zesamoht/Keep-Talking-Project/README.md

# Keep-Talking-Project

A physical homage to the game Keep Talking and Nobody Explode

<p align="center">
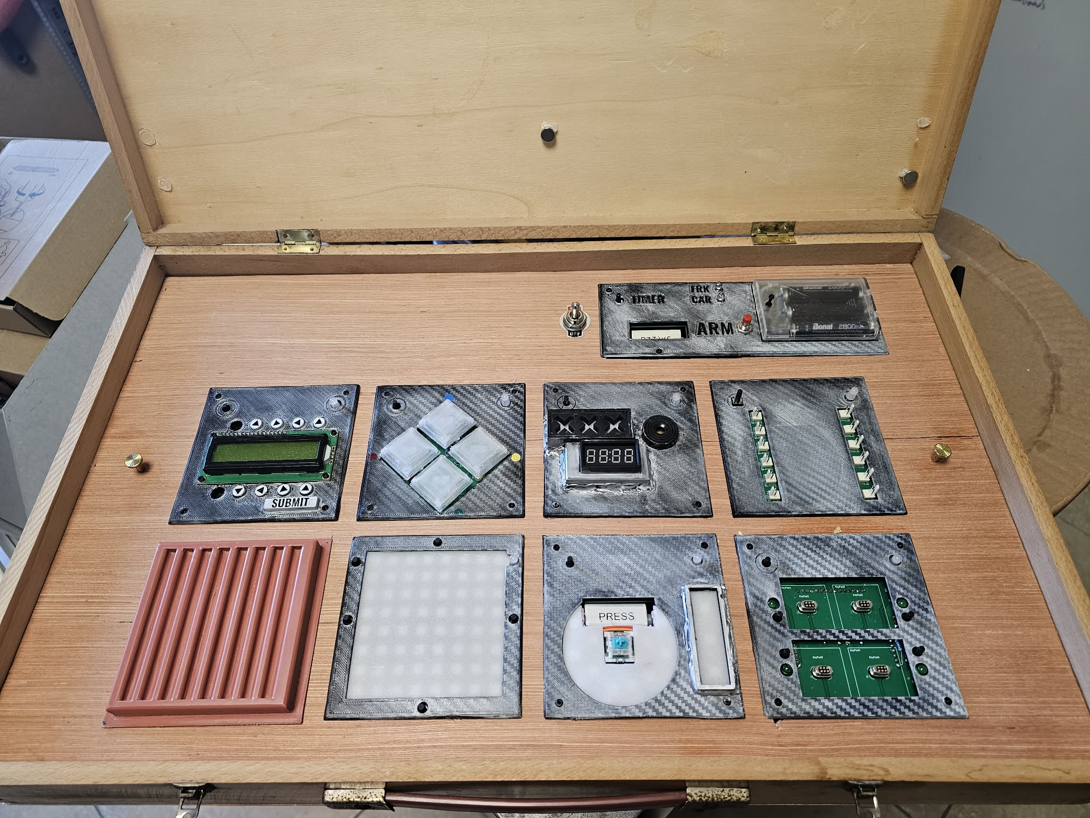
[picture p1: docs/KT_Project.jpg]
  
</p>
