zesamoht/Keep-Talking-Project/arduino/README.md

this folder contains all the arduino code for the working modules
