zesamoht/Keep-Talking-Project/kicad/README.md

For Kicad drawings to be used in the physical manufacturing of the PCB
