zesamoht/Keep-Talking-Project/kicad/Button_Module/EdgeWork_Module.step

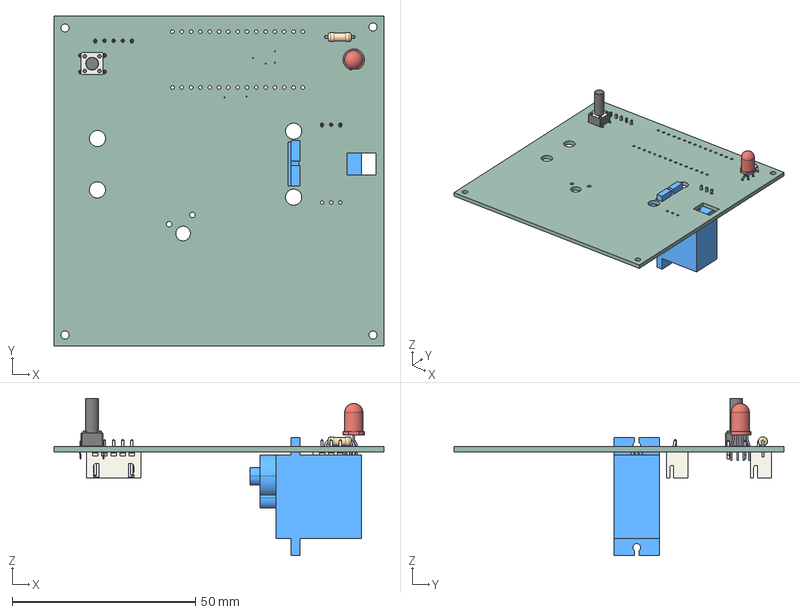
[picture p2: CAD file, 2026-04-25]
kicad/Button_Module/EdgeWork_Module.step
90.0 x 90.0 x 42.9 mm
R_Axial_DIN0207_L6.3mm_D2.5mm_P7.62mm_Horizontal
SW_PUSH_6mm_H13mm
LED_D5.0mm-4_RGB_Staggered_Pins
JST_XH_B5B-XH-A_1x05_P2.50mm_Vertical
JST_XH_B3B-XH-A_1x03_P2.50mm_Vertical
SG90 servo
Button_Module_PCB
