zesamoht/Keep-Talking-Project/kicad/Countdown_Module/Countdown_Module.step

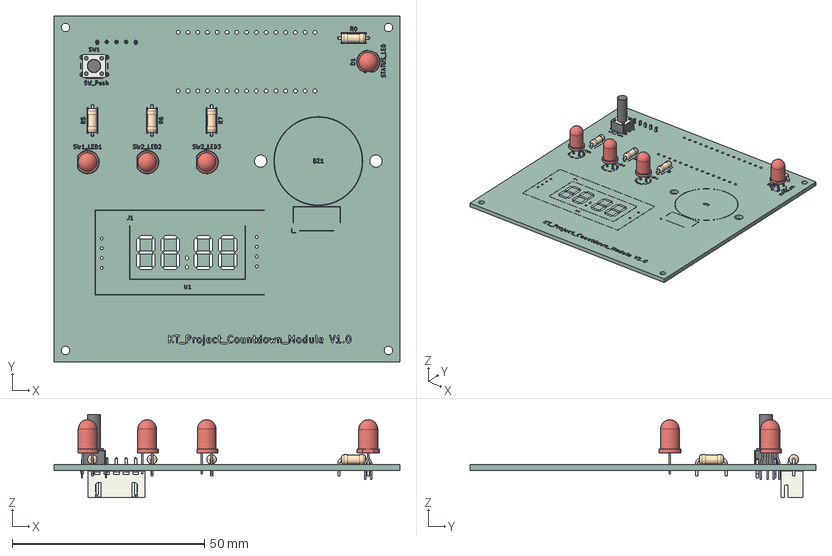
[picture p3: CAD file, 2026-04-25]
kicad/Countdown_Module/Countdown_Module.step
90.0 x 90.0 x 21.7 mm
LED_D5.0mm-4_RGB_Staggered_Pins
R_Axial_DIN0207_L6.3mm_D2.5mm_P7.62mm_Horizontal x 4
LED_D5.0mm x 3
SW_PUSH_6mm_H13mm
JST_XH_B5B-XH-A_1x05_P2.50mm_Vertical
Countdown_Module_silkscreen
Countdown_Module_PCB
