zesamoht/Keep-Talking-Project/kicad/Keypad_PCB/Keypad_PCB.step

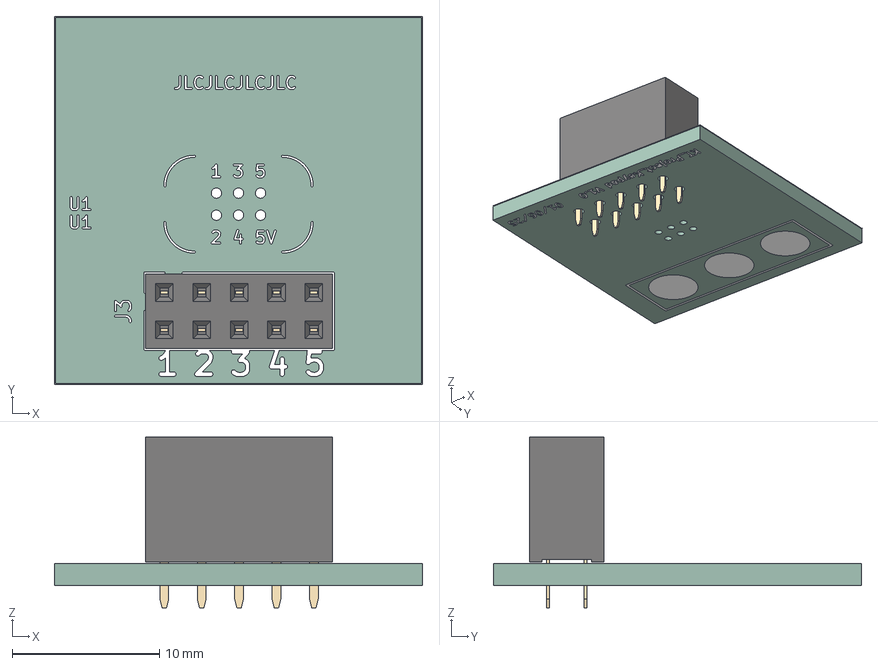
[picture p4: CAD file, 2026-04-25]
kicad/Keypad_PCB/Keypad_PCB.step
25.0 x 25.0 x 11.6 mm
PinSocket_2x05_P2.54mm_Vertical
Keypad_PCB_silkscreen
Keypad_PCB_PCB
