zesamoht/Keep-Talking-Project/kicad/Maze_Module/Maze_Module.step

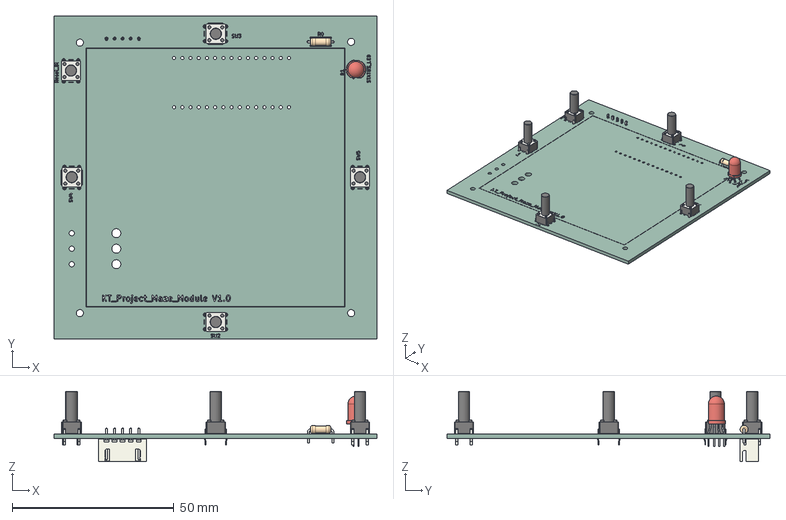
[picture p5: CAD file, 2026-04-25]
kicad/Maze_Module/Maze_Module.step
100.0 x 100.0 x 21.7 mm
R_Axial_DIN0207_L6.3mm_D2.5mm_P7.62mm_Horizontal
SW_PUSH_6mm_H13mm x 5
LED_D5.0mm-4_RGB_Staggered_Pins
JST_XH_B5B-XH-A_1x05_P2.50mm_Vertical
Maze_Module_silkscreen
Maze_Module_PCB
