zesamoht/Keep-Talking-Project/kicad/Password_Module/Password_Module.step

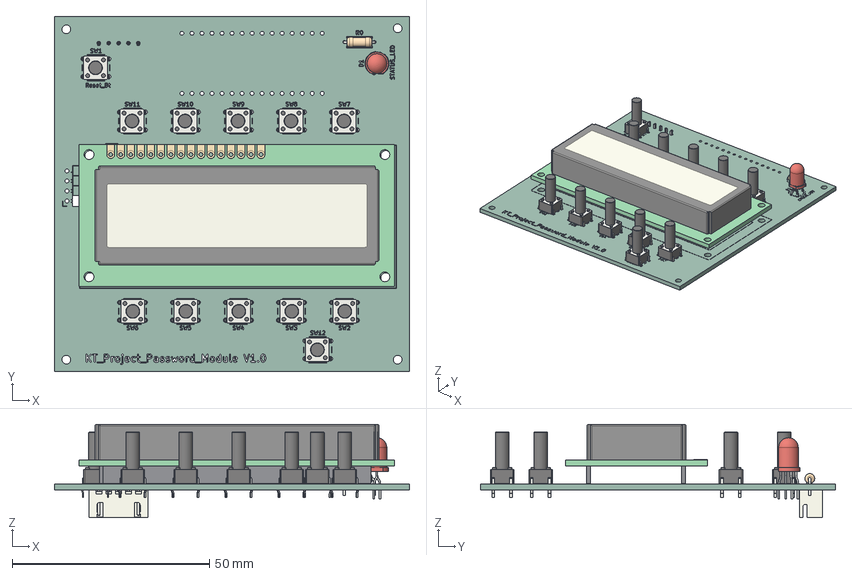
[picture p6: CAD file, 2026-04-25]
kicad/Password_Module/Password_Module.step
90.0 x 90.0 x 23.7 mm
R_Axial_DIN0207_L6.3mm_D2.5mm_P7.62mm_Horizontal
SW_PUSH_6mm_H13mm x 12
WC1602A
LED_D5.0mm-4_RGB_Staggered_Pins
JST_XH_B5B-XH-A_1x05_P2.50mm_Vertical
Password_Module_silkscreen
Password_Module_PCB
