zesamoht/Keep-Talking-Project/kicad/SimonSay_Module/SimonSay_Module.step

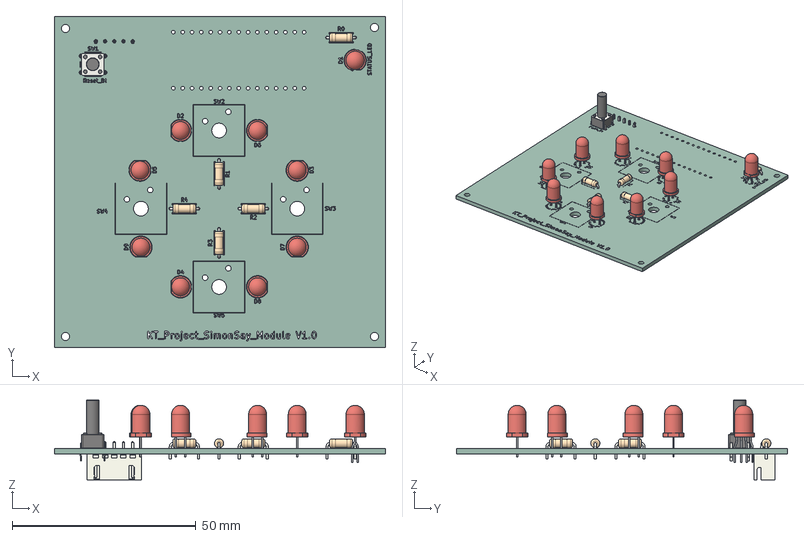
[picture p7: CAD file, 2026-04-25]
kicad/SimonSay_Module/SimonSay_Module.step
90.0 x 90.0 x 21.7 mm
LED_D5.0mm x 8
R_Axial_DIN0207_L6.3mm_D2.5mm_P7.62mm_Horizontal x 5
SW_PUSH_6mm_H13mm
LED_D5.0mm-4_RGB_Staggered_Pins
JST_XH_B5B-XH-A_1x05_P2.50mm_Vertical
SimonSay_Module_silkscreen
SimonSay_Module_PCB
