zesamoht/Keep-Talking-Project/kicad/Wire_Module/Wire_Module.step

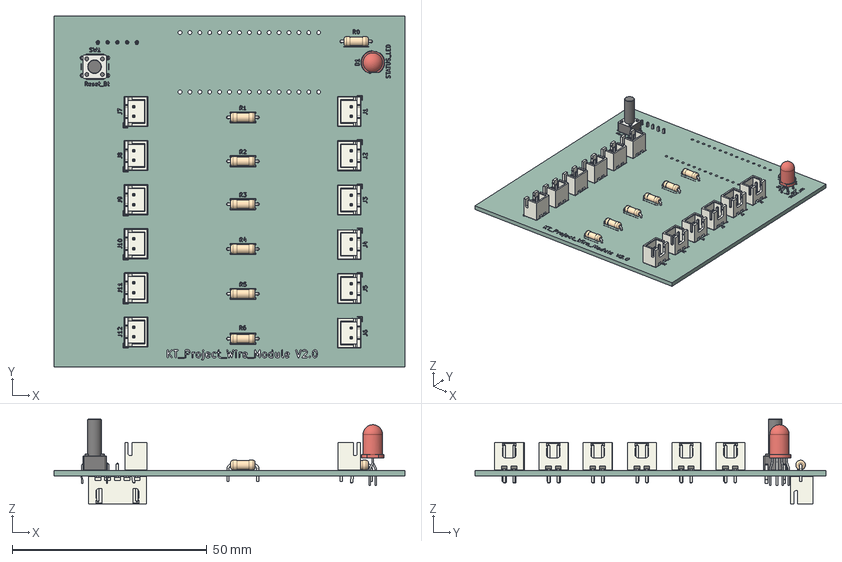
[picture p8: CAD file, 2026-04-25]
kicad/Wire_Module/Wire_Module.step
90.0 x 90.0 x 21.7 mm
R_Axial_DIN0207_L6.3mm_D2.5mm_P7.62mm_Horizontal x 7
JST_XH_B2B-XH-A_1x02_P2.50mm_Vertical x 12
SW_PUSH_6mm_H13mm
LED_D5.0mm-4_RGB_Staggered_Pins
JST_XH_B5B-XH-A_1x05_P2.50mm_Vertical
Wire_Module_silkscreen
Wire_Module_PCB
