zesamoht/Keep-Talking-Project/kicad/Password_Module/Password_Module.kicad_pcb

## KiCad design kicad/Password_Module/Password_Module.kicad_pcb (2026-04-25)

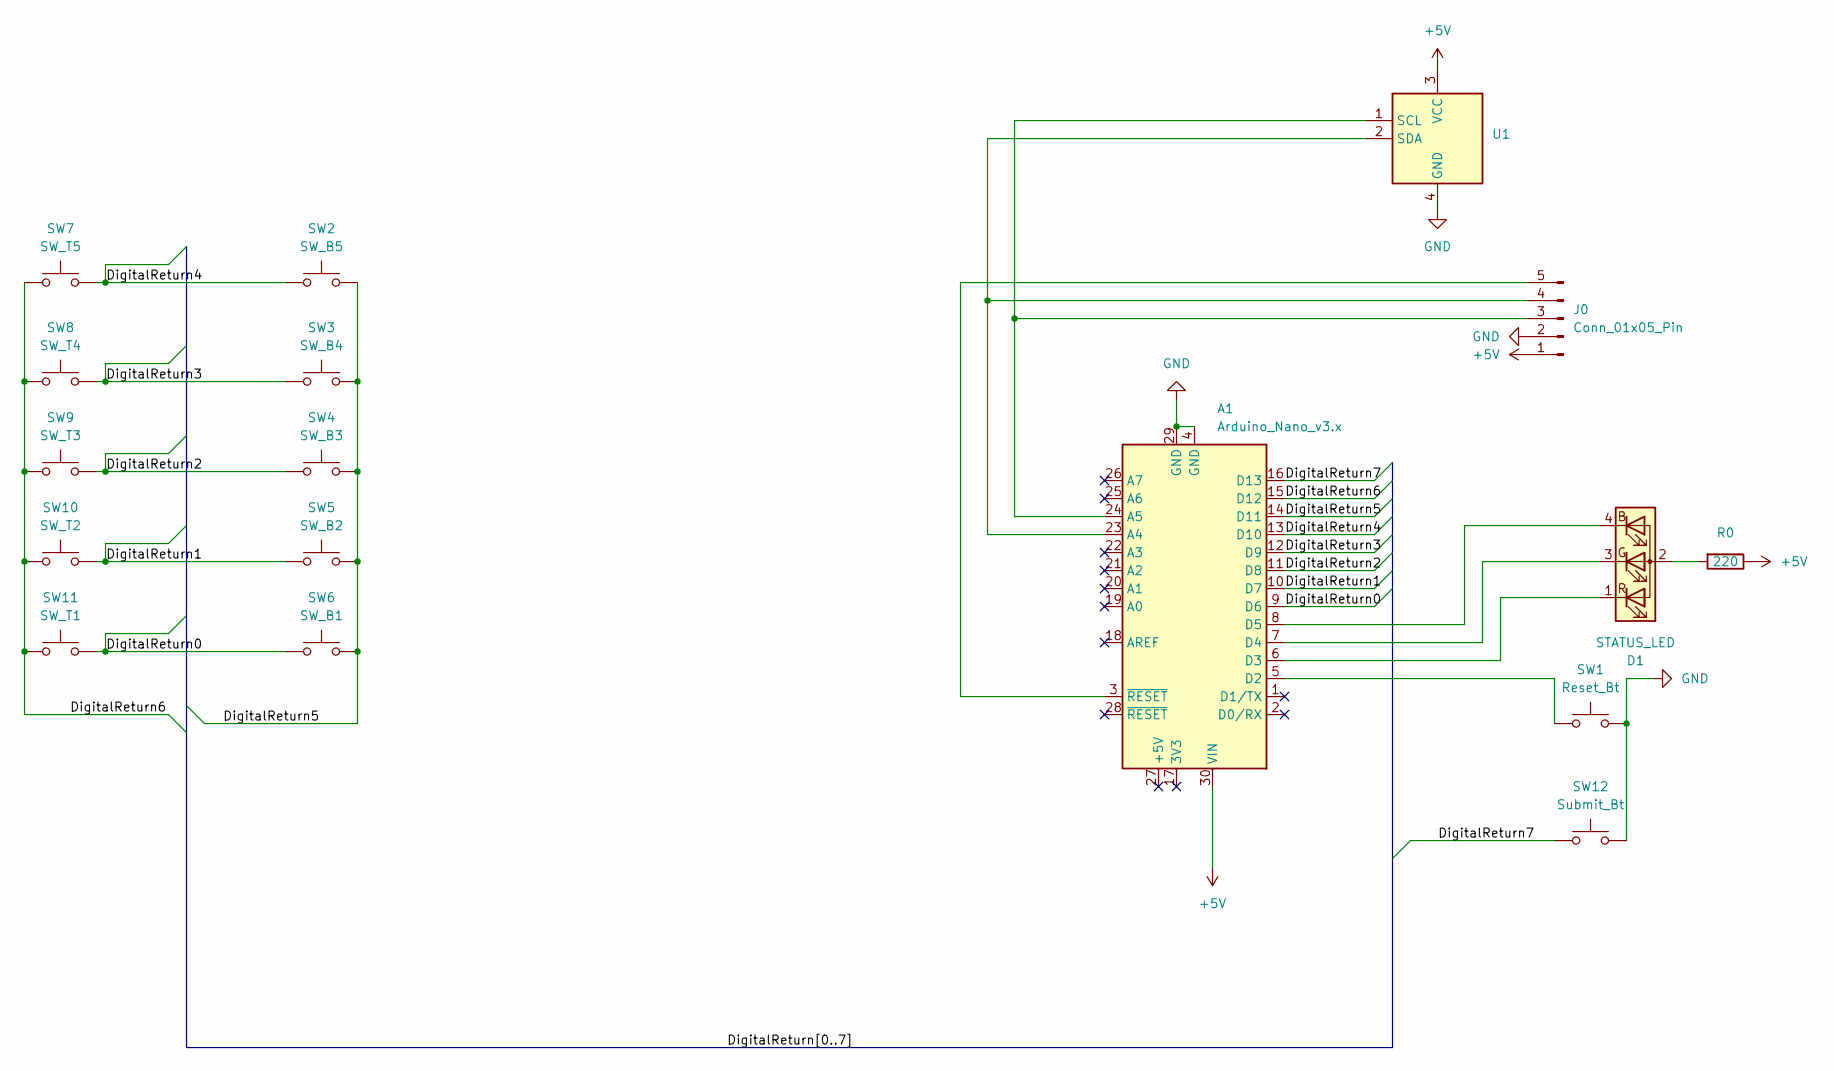
[picture p9: schematic Password_Module.kicad_sch]

Parts:
A1: Arduino_Nano_v3.x; Arduino_Nano
D1: STATUS_LED; LED_D5.0mm-4_RGB_Staggered_Pins
J0: Conn_01x05_Pin; JST_XH_B5B-XH-A_1x05_P2.50mm_Vertical
R0: 220; R_Axial_DIN0207_L6.3mm_D2.5mm_P7.62mm_Horizontal
SW1: Reset_Bt; SW_PUSH_6mm_H13mm
SW2: SW_B5; SW_PUSH_6mm_H13mm
SW3: SW_B4; SW_PUSH_6mm_H13mm
SW4: SW_B3; SW_PUSH_6mm_H13mm
SW5: SW_B2; SW_PUSH_6mm_H13mm
SW6: SW_B1; SW_PUSH_6mm_H13mm
SW7: SW_T5; SW_PUSH_6mm_H13mm
SW8: SW_T4; SW_PUSH_6mm_H13mm
SW9: SW_T3; SW_PUSH_6mm_H13mm
SW10: SW_T2; SW_PUSH_6mm_H13mm
SW11: SW_T1; SW_PUSH_6mm_H13mm
SW12: Submit_Bt; SW_PUSH_6mm_H13mm
U1: LCD I2C 8x2 (PCF8574T) I2C

Connections:
+5V: A1.30 (VIN), J0.1, R0.1, U1.3 (VCC)
/DigitalReturn0: A1.9 (D6), SW6.2, SW11.2
/DigitalReturn1: A1.10 (D7), SW5.2, SW10.2
/DigitalReturn2: A1.11 (D8), SW4.2, SW9.2
/DigitalReturn3: A1.12 (D9), SW3.2, SW8.2
/DigitalReturn4: A1.13 (D10), SW2.2, SW7.2
/DigitalReturn5: A1.14 (D11), SW2.1, SW3.1, SW4.1, SW5.1, SW6.1
/DigitalReturn6: A1.15 (D12), SW7.1, SW8.1, SW9.1, SW10.1, SW11.1
/DigitalReturn7: A1.16 (D13), SW12.1
GND: A1.4 (GND), A1.29 (GND), J0.2, SW1.2, SW12.2, U1.4 (GND)
unnamed: A1.23 (A4), J0.4, U1.2 (SDA)
unnamed: A1.24 (A5), J0.3, U1.1 (SCL)
unnamed: A1.5 (D2), SW1.1
unnamed: A1.6 (D3), D1.1 (RK)
unnamed: A1.7 (D4), D1.3 (GK)
unnamed: A1.8 (D5), D1.4 (BK)
unnamed: D1.2 (A), R0.2
unnamed: A1.3 (~RESET), J0.5

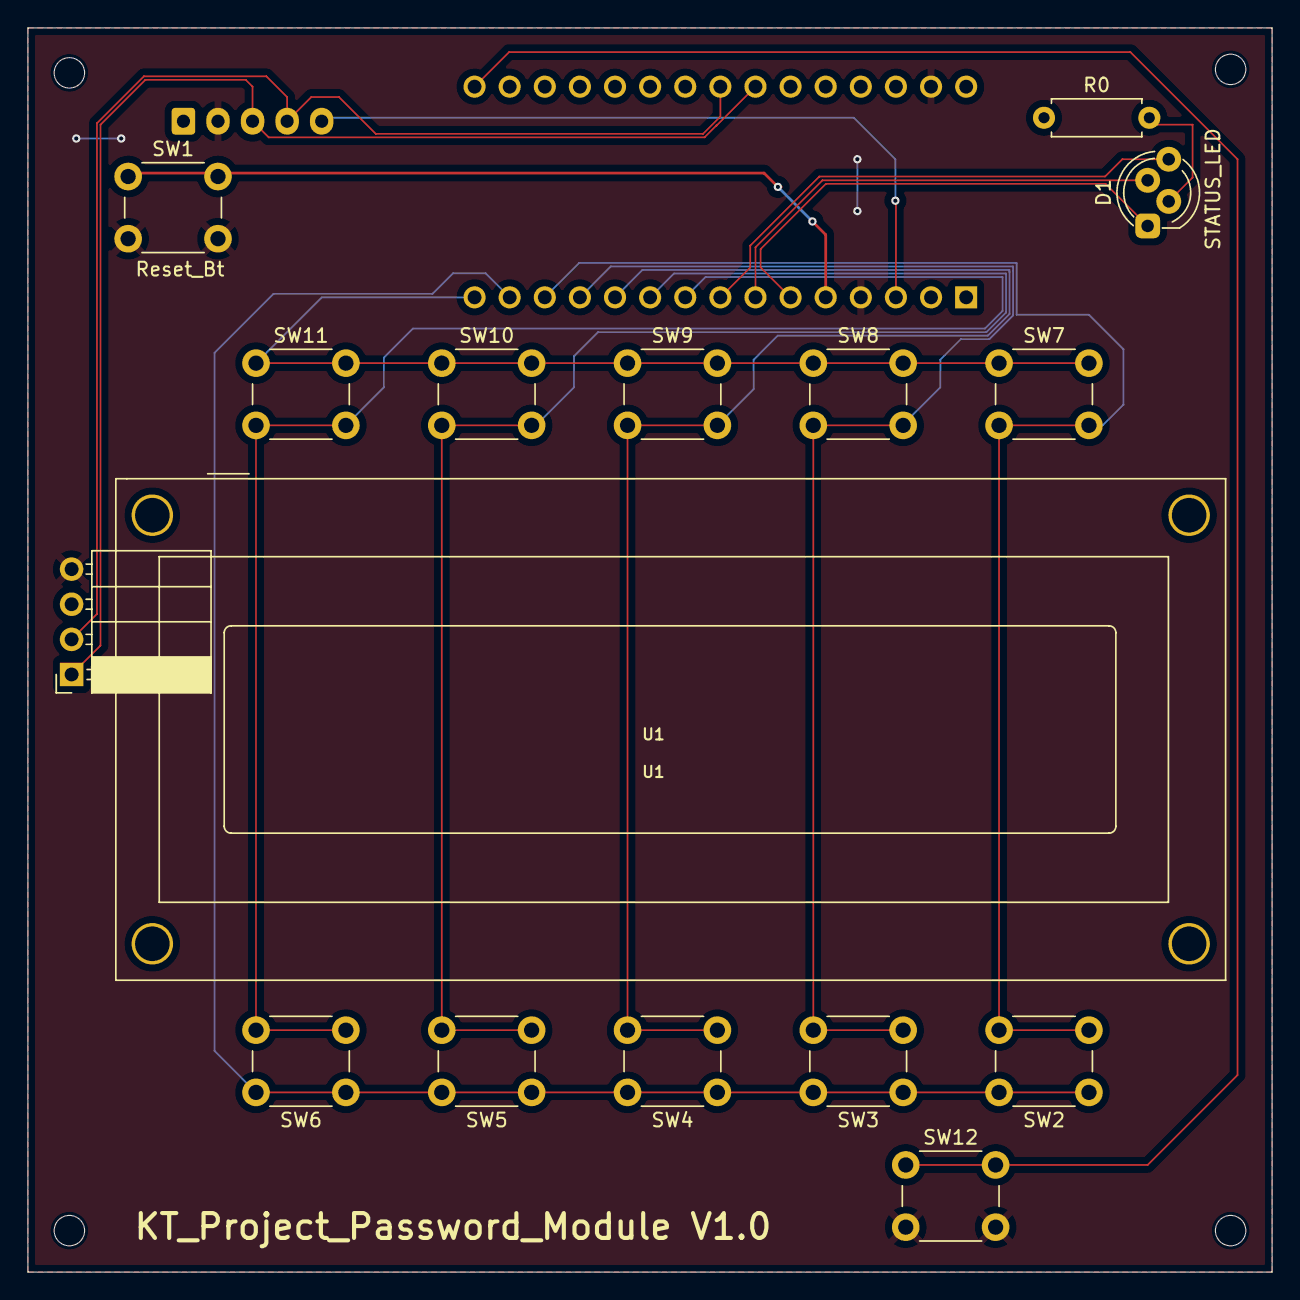
[picture p10: board Password_Module.kicad_pcb from above]

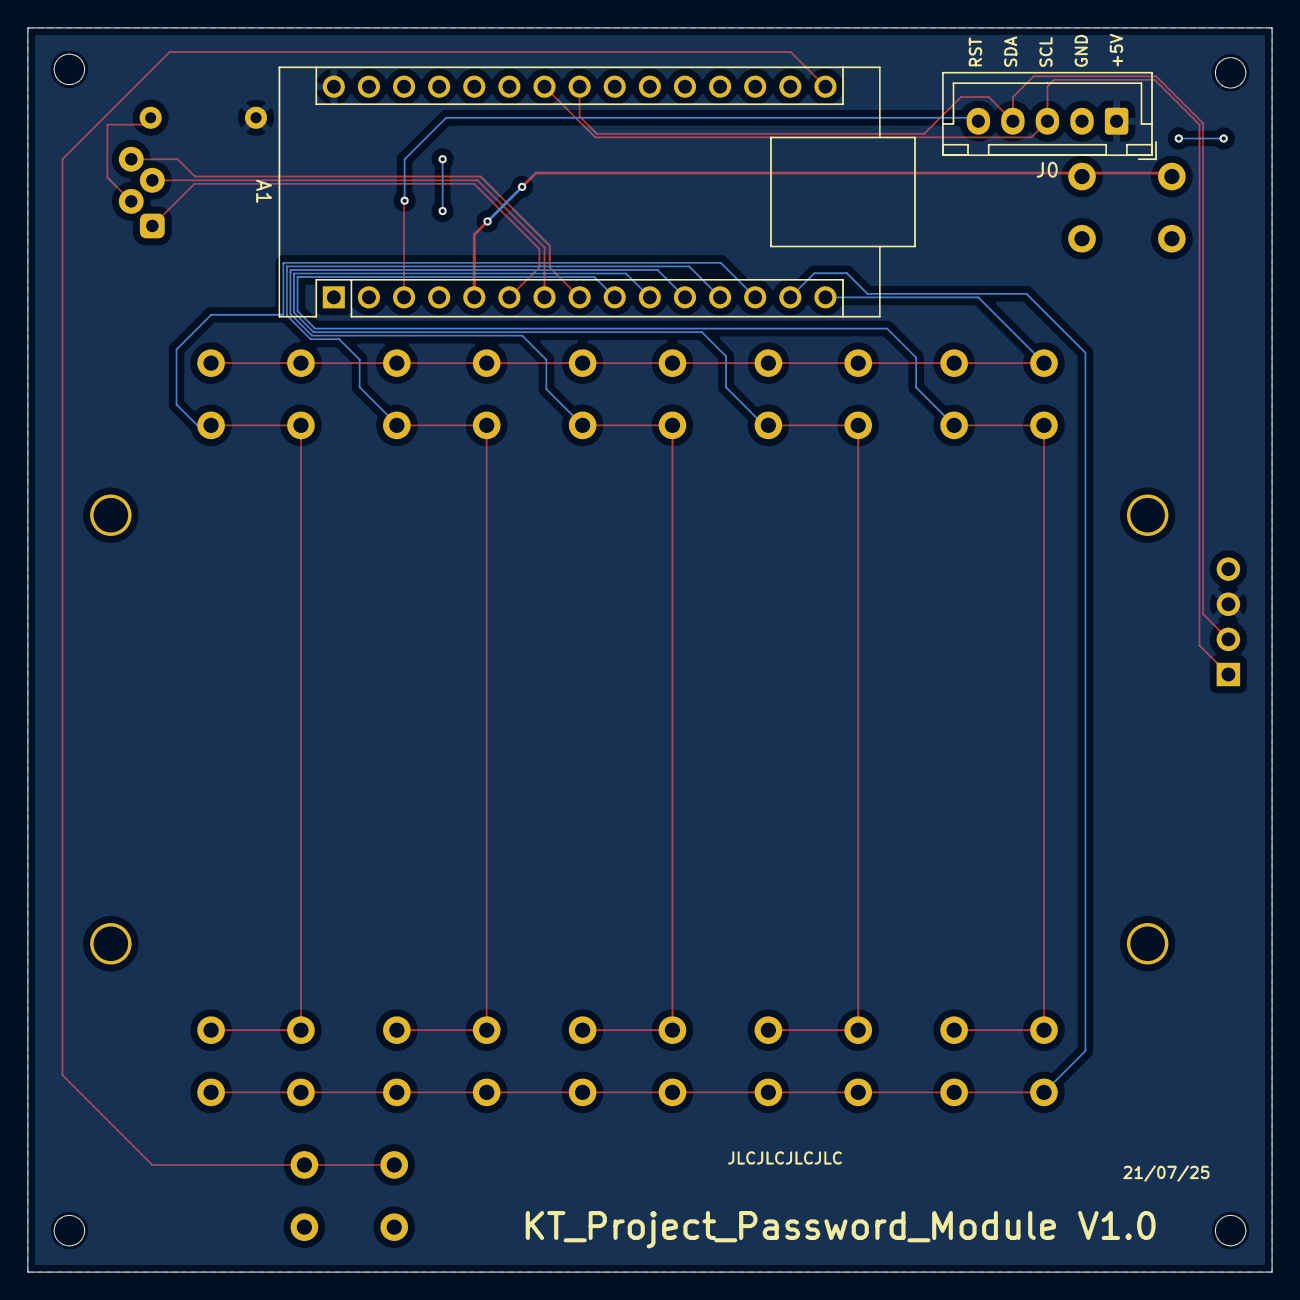
[picture p11: board Password_Module.kicad_pcb from below]

Board: 2 copper layers, 90.0 x 90.0 mm, 17 parts (2 on the bottom side), 18 nets.
