zesamoht/Keep-Talking-Project/kicad/Memory_Module/Memory_Module.kicad_pcb

## KiCad design kicad/Memory_Module/Memory_Module.kicad_pcb (2026-04-25)

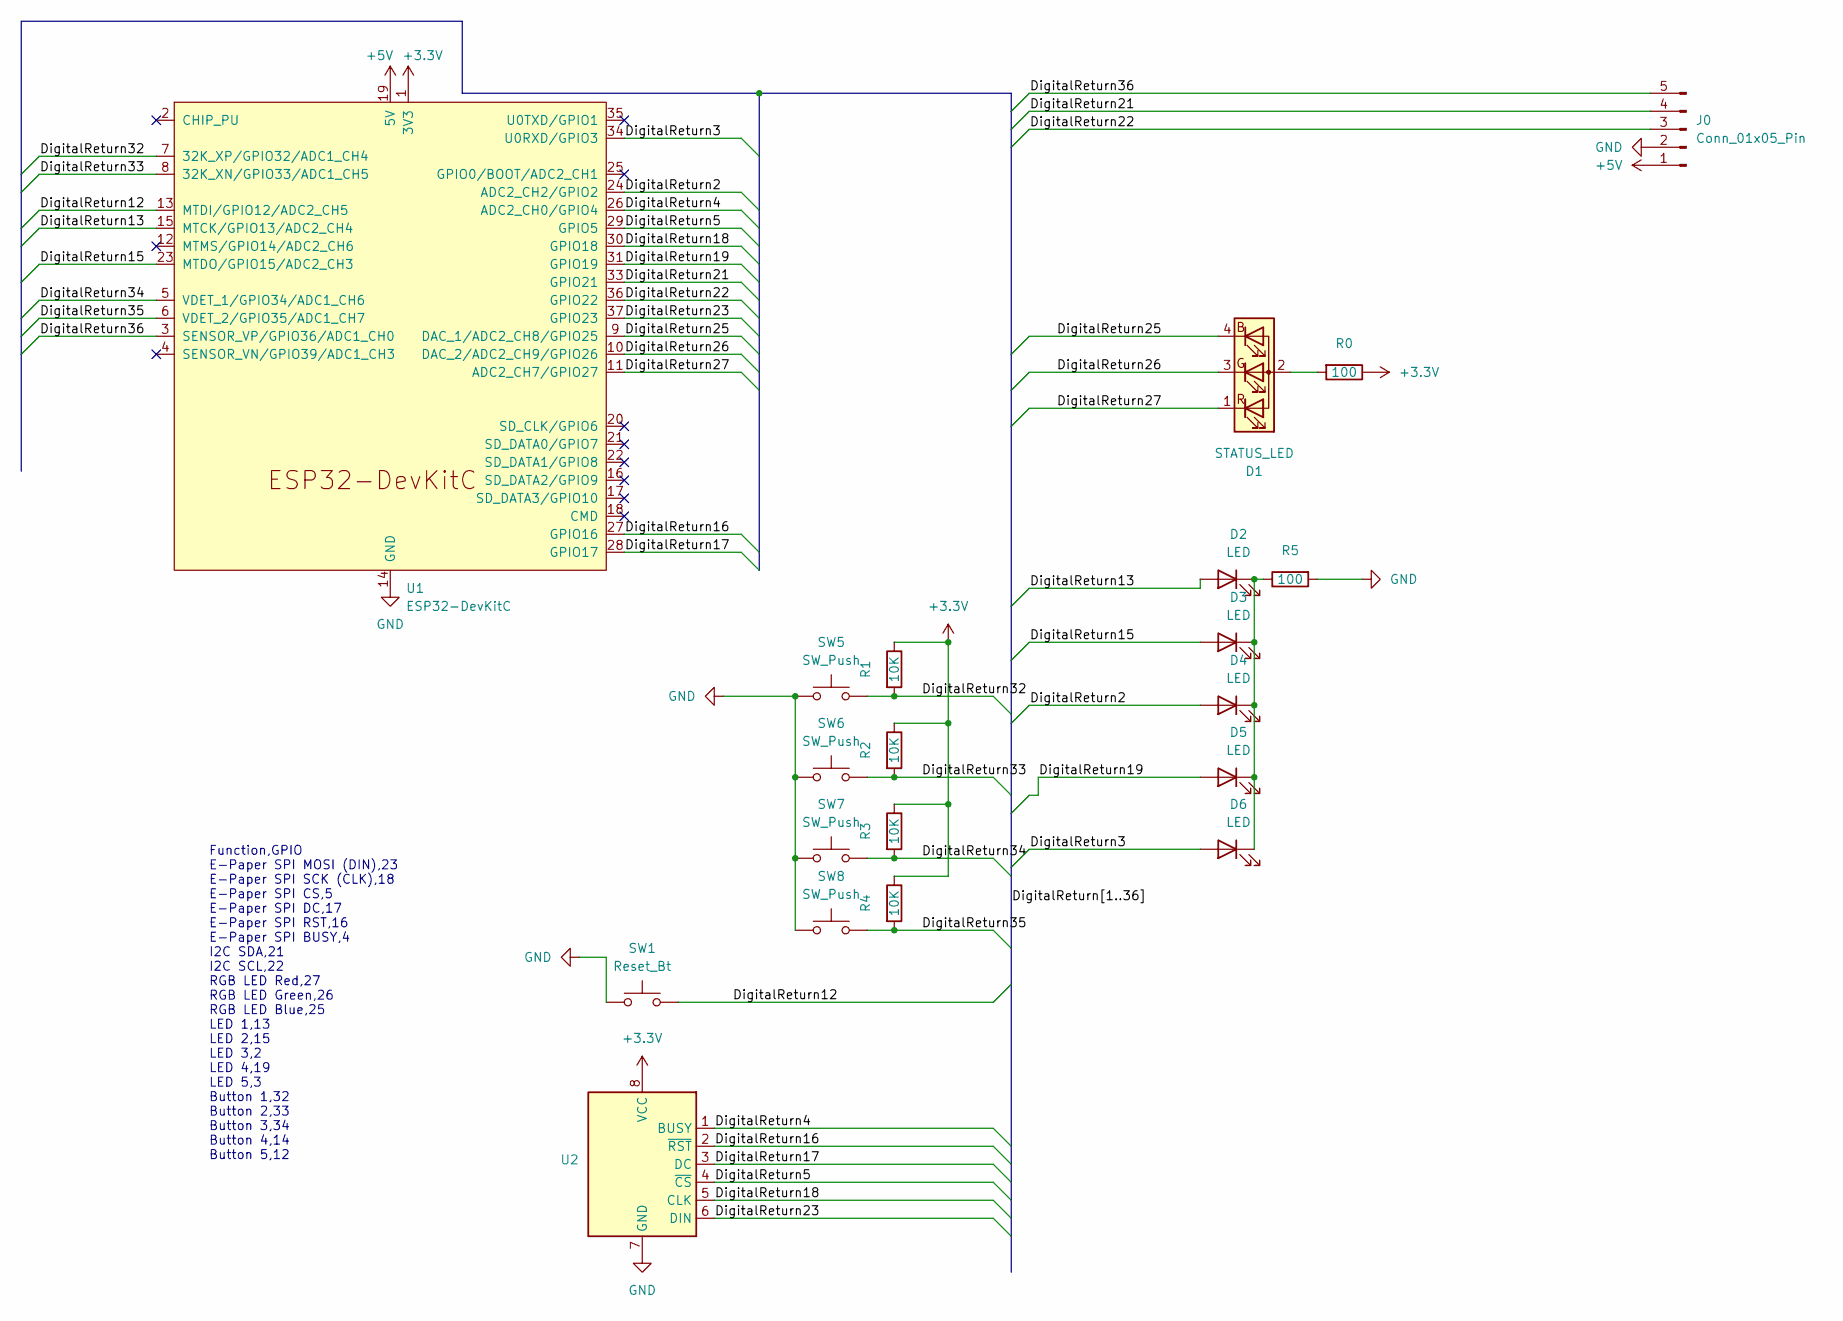
[picture p12: schematic Memory_Module.kicad_sch]

Parts:
D1: STATUS_LED; LED_D5.0mm-4_RGB_Staggered_Pins
D2, D3, D4, D5, D6: LED; LED_D5.0mm
J0: Conn_01x05_Pin; JST_XH_B5B-XH-A_1x05_P2.50mm_Vertical
R0, R5: 100; R_Axial_DIN0207_L6.3mm_D2.5mm_P7.62mm_Horizontal
R1, R2, R3, R4: 10K; R_Axial_DIN0207_L6.3mm_D2.5mm_P7.62mm_Horizontal
SW1: Reset_Bt; SW_PUSH_6mm_H13mm
SW5, SW6, SW7, SW8: SW_Push; SW_PUSH_6mm_H13mm
U1: ESP32-DevKitC
U2: WaveShare_E-Paper_Display_200x200

Connections:
+3.3V: R0.1, R1.1, R2.1, R3.1, R4.1, U1.1 (3V3), U2.8 (VCC)
+5V: J0.1, U1.19 (5V)
/DigitalReturn2: D4.2 (A), U1.24 (ADC2_CH2/GPIO2)
/DigitalReturn3: D6.2 (A), U1.34 (U0RXD/GPIO3)
/DigitalReturn4: U1.26 (ADC2_CH0/GPIO4), U2.1 (BUSY)
/DigitalReturn5: U1.29 (GPIO5), U2.4 (~CS)
/DigitalReturn12: SW1.1, U1.13 (MTDI/GPIO12/ADC2_CH5)
/DigitalReturn13: D2.2 (A), U1.15 (MTCK/GPIO13/ADC2_CH4)
/DigitalReturn15: D3.2 (A), U1.23 (MTDO/GPIO15/ADC2_CH3)
/DigitalReturn16: U1.27 (GPIO16), U2.2 (~RST)
/DigitalReturn17: U1.28 (GPIO17), U2.3 (DC)
/DigitalReturn18: U1.30 (GPIO18), U2.5 (CLK)
/DigitalReturn19: D5.2 (A), U1.31 (GPIO19)
/DigitalReturn21: J0.4, U1.33 (GPIO21)
/DigitalReturn22: J0.3, U1.36 (GPIO22)
/DigitalReturn23: U1.37 (GPIO23), U2.6 (DIN)
/DigitalReturn25: D1.4 (BK), U1.9 (DAC_1/ADC2_CH8/GPIO25)
/DigitalReturn26: D1.3 (GK), U1.10 (DAC_2/ADC2_CH9/GPIO26)
/DigitalReturn27: D1.1 (RK), U1.11 (ADC2_CH7/GPIO27)
/DigitalReturn32: R1.2, SW5.2, U1.7 (32K_XP/GPIO32/ADC1_CH4)
/DigitalReturn33: R2.2, SW6.2, U1.8 (32K_XN/GPIO33/ADC1_CH5)
/DigitalReturn34: R3.2, SW7.2, U1.5 (VDET_1/GPIO34/ADC1_CH6)
/DigitalReturn35: R4.2, SW8.2, U1.6 (VDET_2/GPIO35/ADC1_CH7)
/DigitalReturn36: J0.5, U1.3 (SENSOR_VP/GPIO36/ADC1_CH0)
GND: J0.2, R5.2, SW1.2, SW5.1, SW6.1, SW7.1, SW8.1, U1.14 (GND), U1.32 (GND), U1.38 (GND), U2.7 (GND)
unnamed: D1.2 (A), R0.2
unnamed: D2.1 (K), D3.1 (K), D4.1 (K), D5.1 (K), D6.1 (K), R5.1

Notes on the sheet:
Function,GPIO E-Paper SPI MOSI (DIN),23 E-Paper SPI SCK (CLK),18 E-Paper SPI CS,5 E-Paper SPI DC,17 E-Paper SPI RST,16 E-Paper SPI BUSY,4 I2C SDA,21 I2C SCL,22 RGB LED Red,27 RGB LED Green,26 RGB LED Blue,25 LED 1,13 LED 2,15 LED 3,2 LED 4,19 LED 5,3 Button 1,32 Button 2,33 Button 3,34 Button 4,14 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

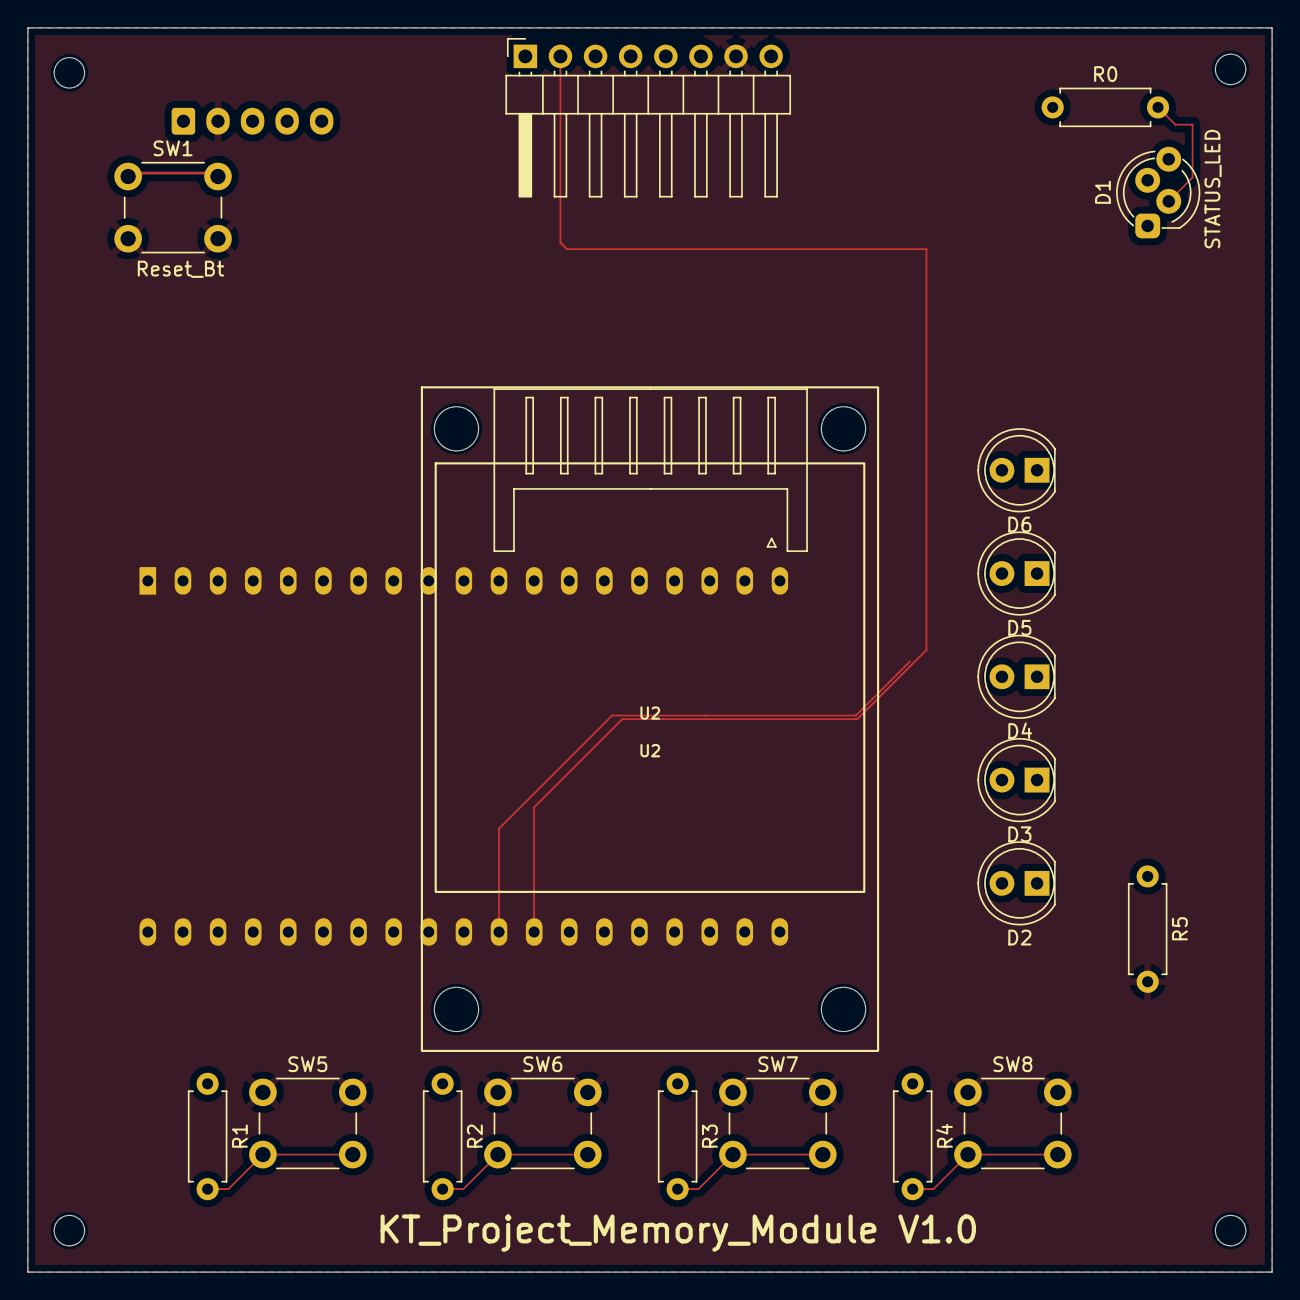
[picture p13: board Memory_Module.kicad_pcb from above]

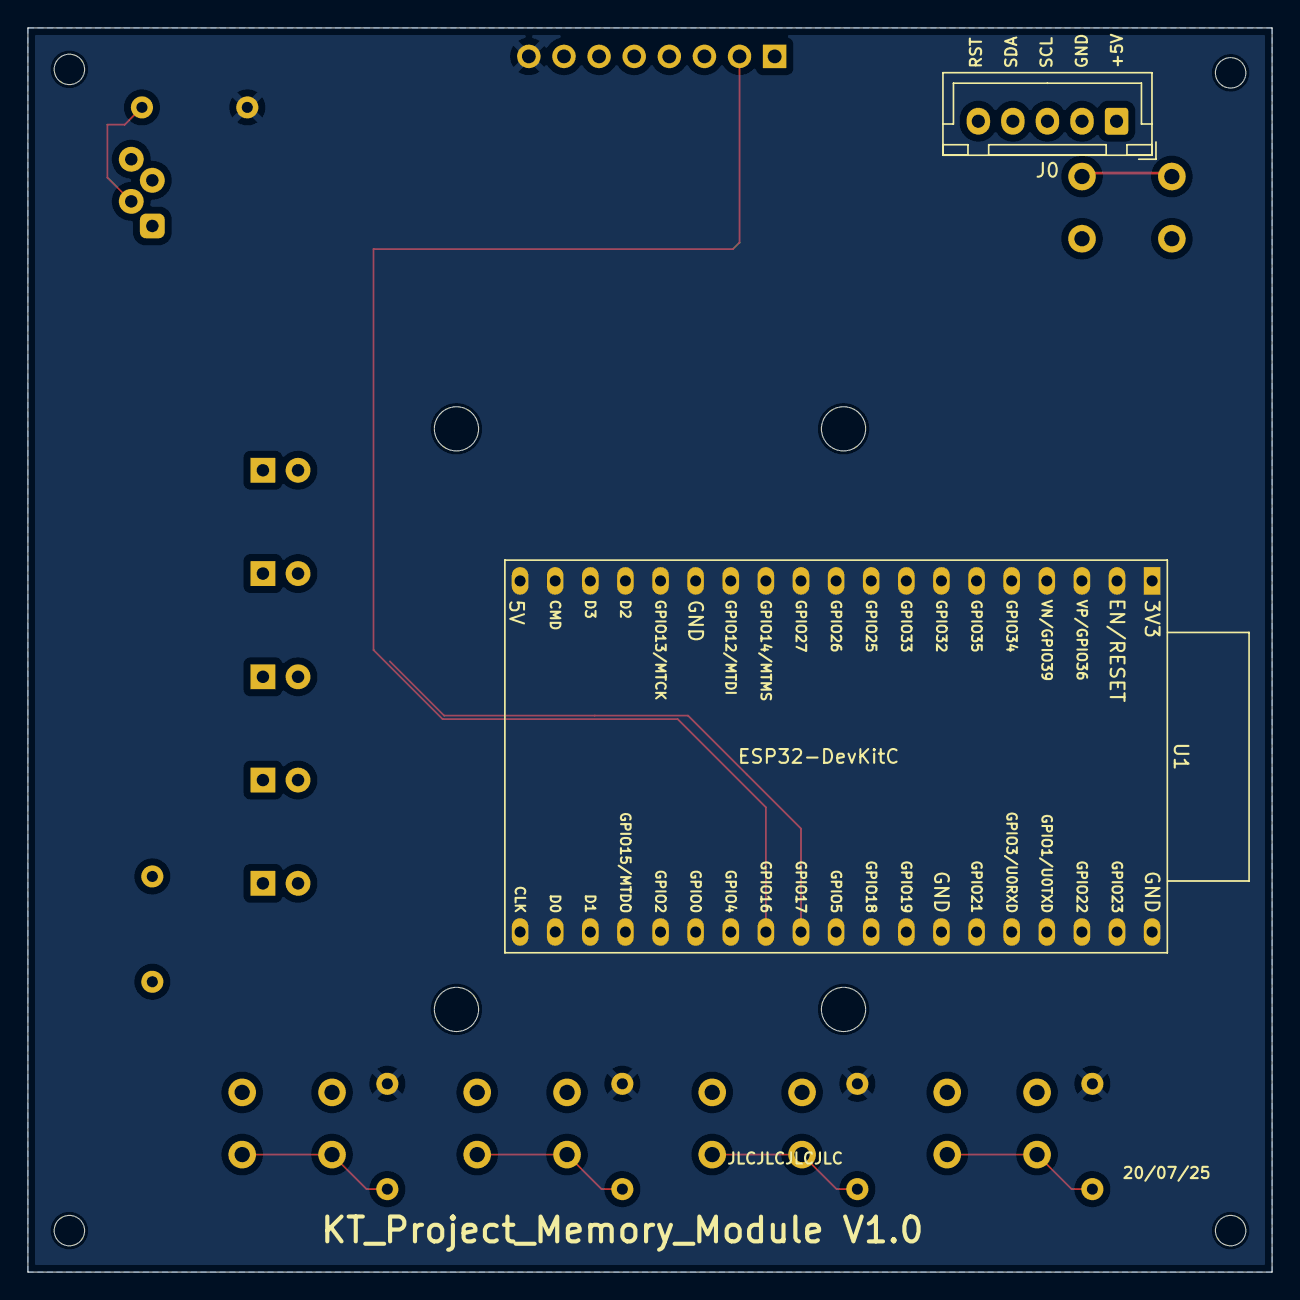
[picture p14: board Memory_Module.kicad_pcb from below]

Board: 2 copper layers, 90.0 x 90.0 mm, 20 parts (2 on the bottom side), 27 nets.
