zesamoht/Keep-Talking-Project/kicad/SimonSay_Module/SimonSay_Module.kicad_pcb

## KiCad design kicad/SimonSay_Module/SimonSay_Module.kicad_pcb (2026-04-25)

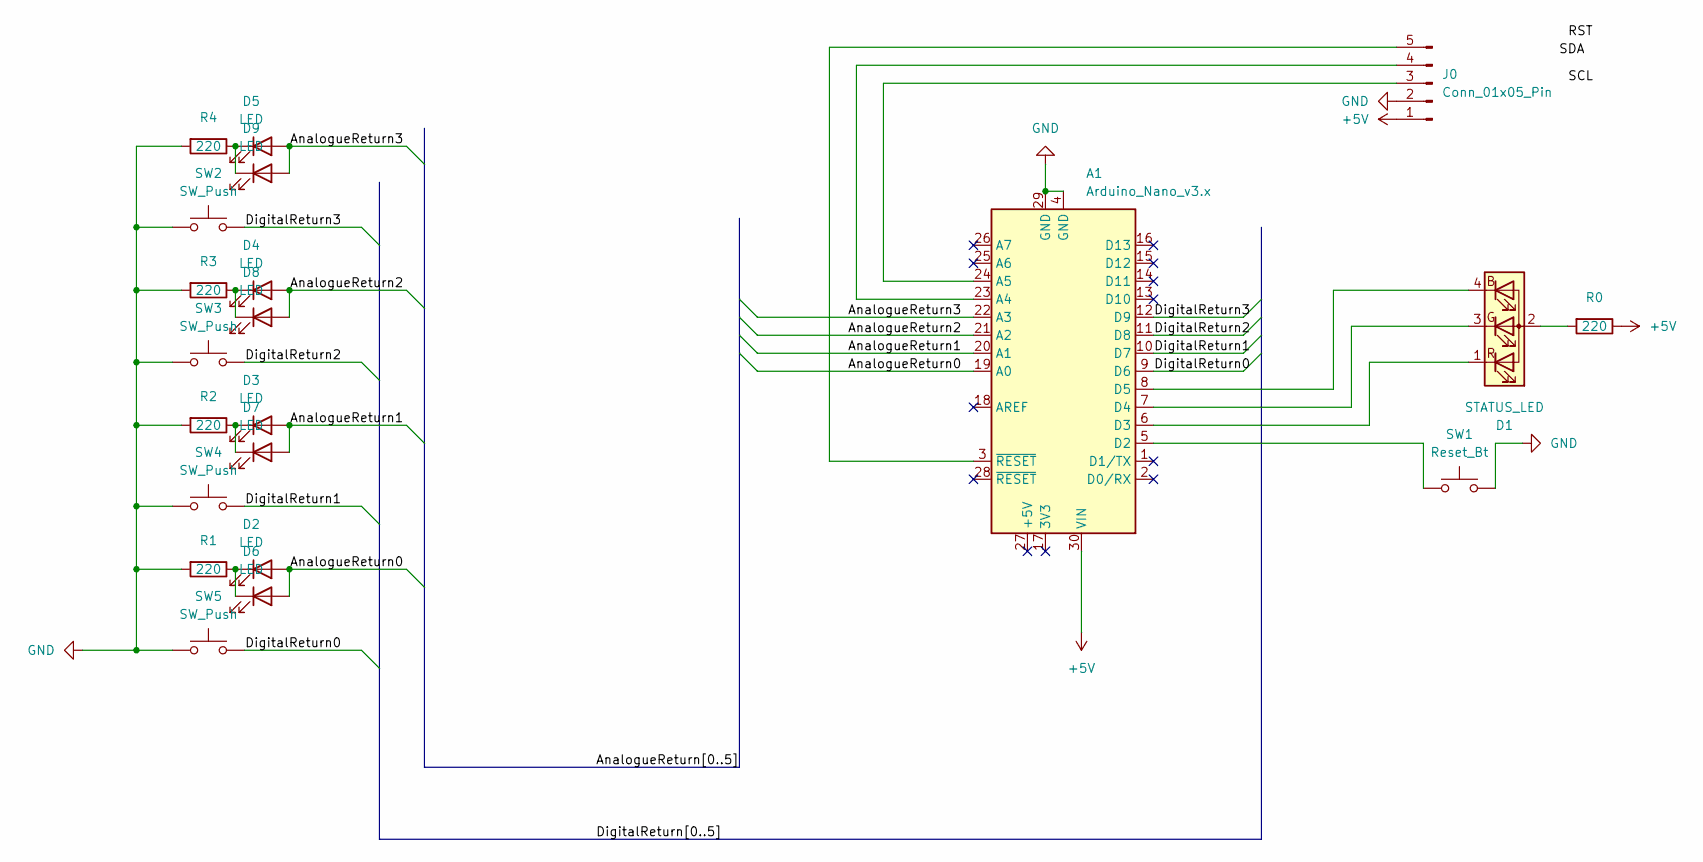
[picture p15: schematic SimonSay_Module.kicad_sch]

Parts:
A1: Arduino_Nano_v3.x; Arduino_Nano
D1: STATUS_LED; LED_D5.0mm-4_RGB_Staggered_Pins
D2, D3, D4, D5, D6, D7, D8, D9: LED; LED_D5.0mm
J0: Conn_01x05_Pin; JST_XH_B5B-XH-A_1x05_P2.50mm_Vertical
R0, R1, R2, R3, R4: 220; R_Axial_DIN0207_L6.3mm_D2.5mm_P7.62mm_Horizontal
SW1: Reset_Bt; SW_PUSH_6mm_H13mm
SW2, SW3, SW4, SW5: SW_Push; SW_Cherry_MX_1.00u_Plate

Connections:
+5V: A1.30 (VIN), J0.1, R0.1
/AnalogueReturn0: A1.19 (A0), D2.2 (A), D6.2 (A)
/AnalogueReturn1: A1.20 (A1), D3.2 (A), D7.2 (A)
/AnalogueReturn2: A1.21 (A2), D4.2 (A), D8.2 (A)
/AnalogueReturn3: A1.22 (A3), D5.2 (A), D9.2 (A)
/DigitalReturn0: A1.9 (D6), SW5.2
/DigitalReturn1: A1.10 (D7), SW4.2
/DigitalReturn2: A1.11 (D8), SW3.2
/DigitalReturn3: A1.12 (D9), SW2.2
GND: A1.4 (GND), A1.29 (GND), J0.2, R1.2, R2.2, R3.2, R4.2, SW1.2, SW2.1, SW3.1, SW4.1, SW5.1
unnamed: A1.23 (A4), J0.4
unnamed: A1.24 (A5), J0.3
unnamed: A1.5 (D2), SW1.1
unnamed: A1.6 (D3), D1.1 (RK)
unnamed: A1.7 (D4), D1.3 (GK)
unnamed: A1.8 (D5), D1.4 (BK)
unnamed: D1.2 (A), R0.2
unnamed: D2.1 (K), D6.1 (K), R1.1
unnamed: D3.1 (K), D7.1 (K), R2.1
unnamed: D4.1 (K), D8.1 (K), R3.1
unnamed: D5.1 (K), D9.1 (K), R4.1
unnamed: A1.3 (~RESET), J0.5

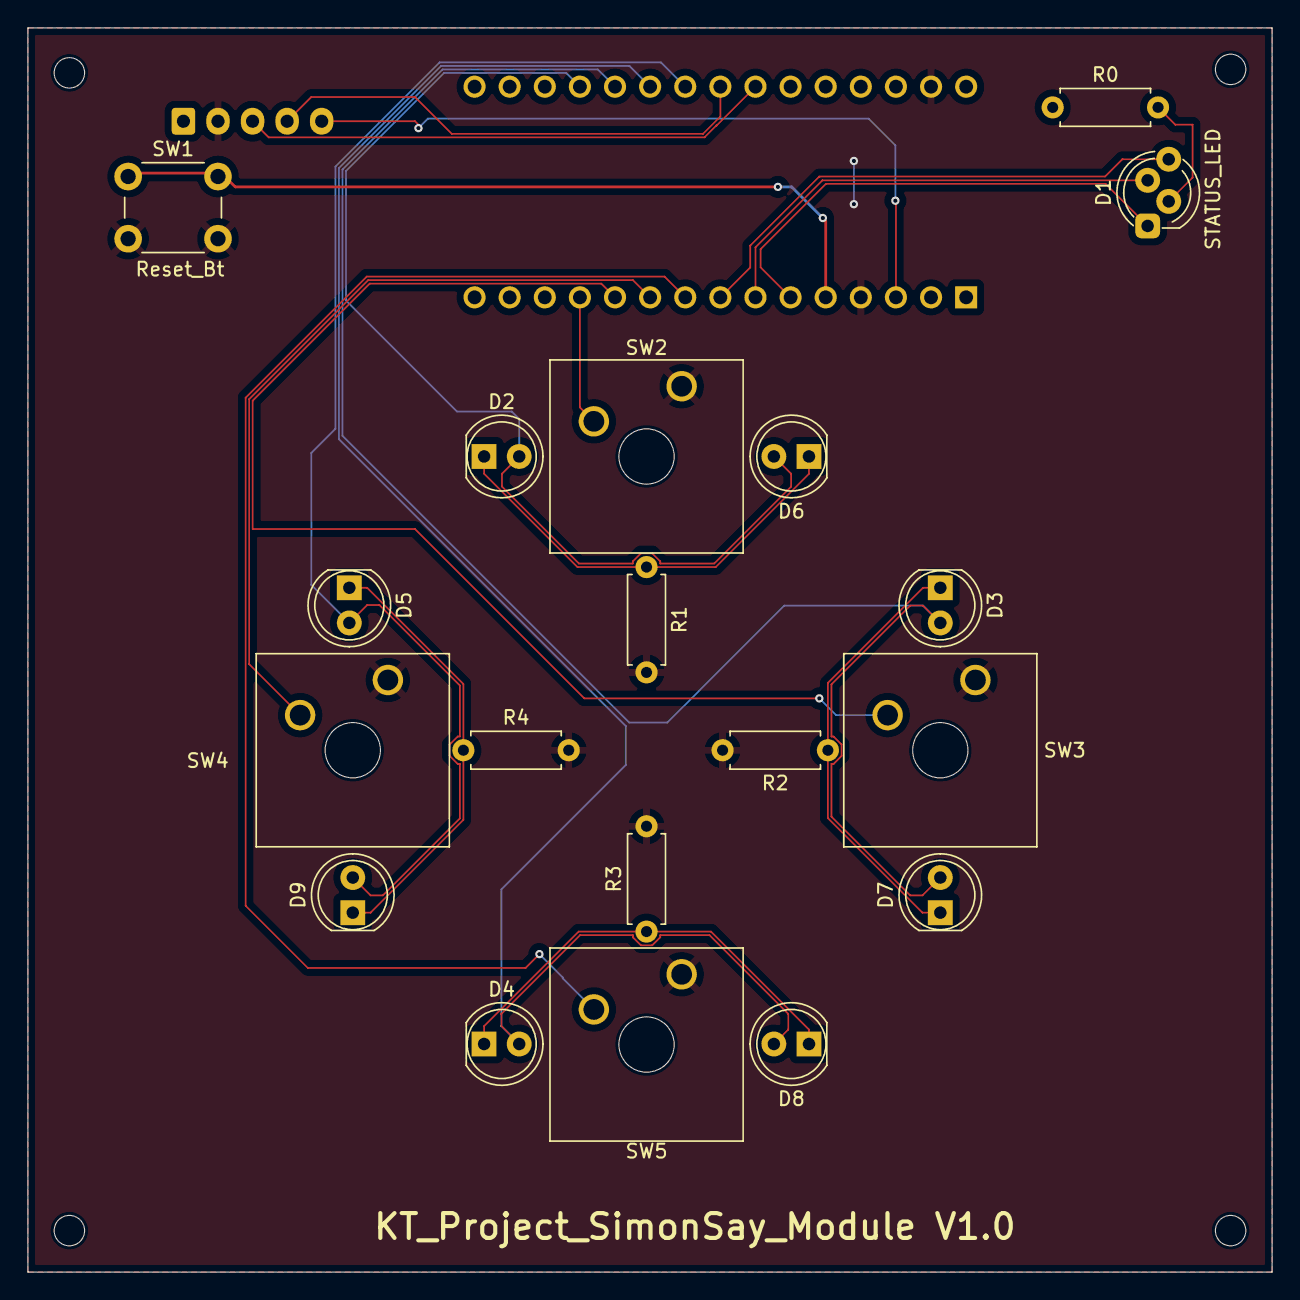
[picture p16: board SimonSay_Module.kicad_pcb from above]

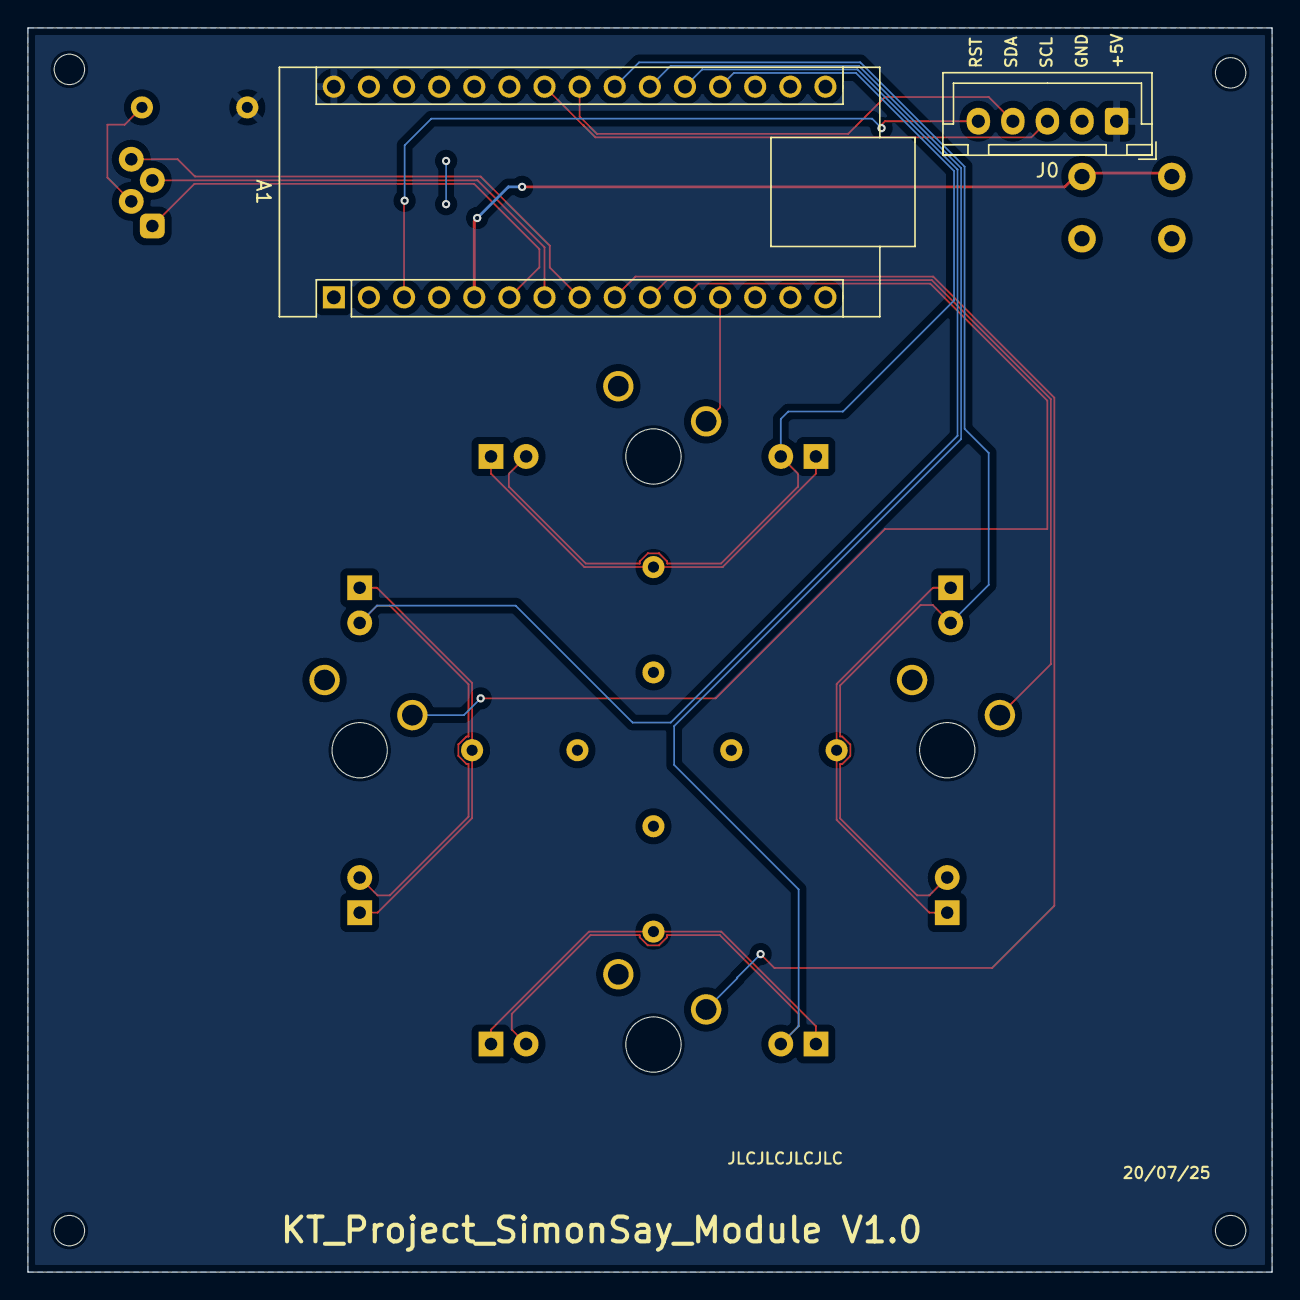
[picture p17: board SimonSay_Module.kicad_pcb from below]

Board: 2 copper layers, 90.0 x 90.0 mm, 21 parts (2 on the bottom side), 22 nets.
