zesamoht/Keep-Talking-Project/kicad/Keyboard_Module/Keyboard_Module.kicad_pcb

## KiCad design kicad/Keyboard_Module/Keyboard_Module.kicad_pcb (2026-04-25)

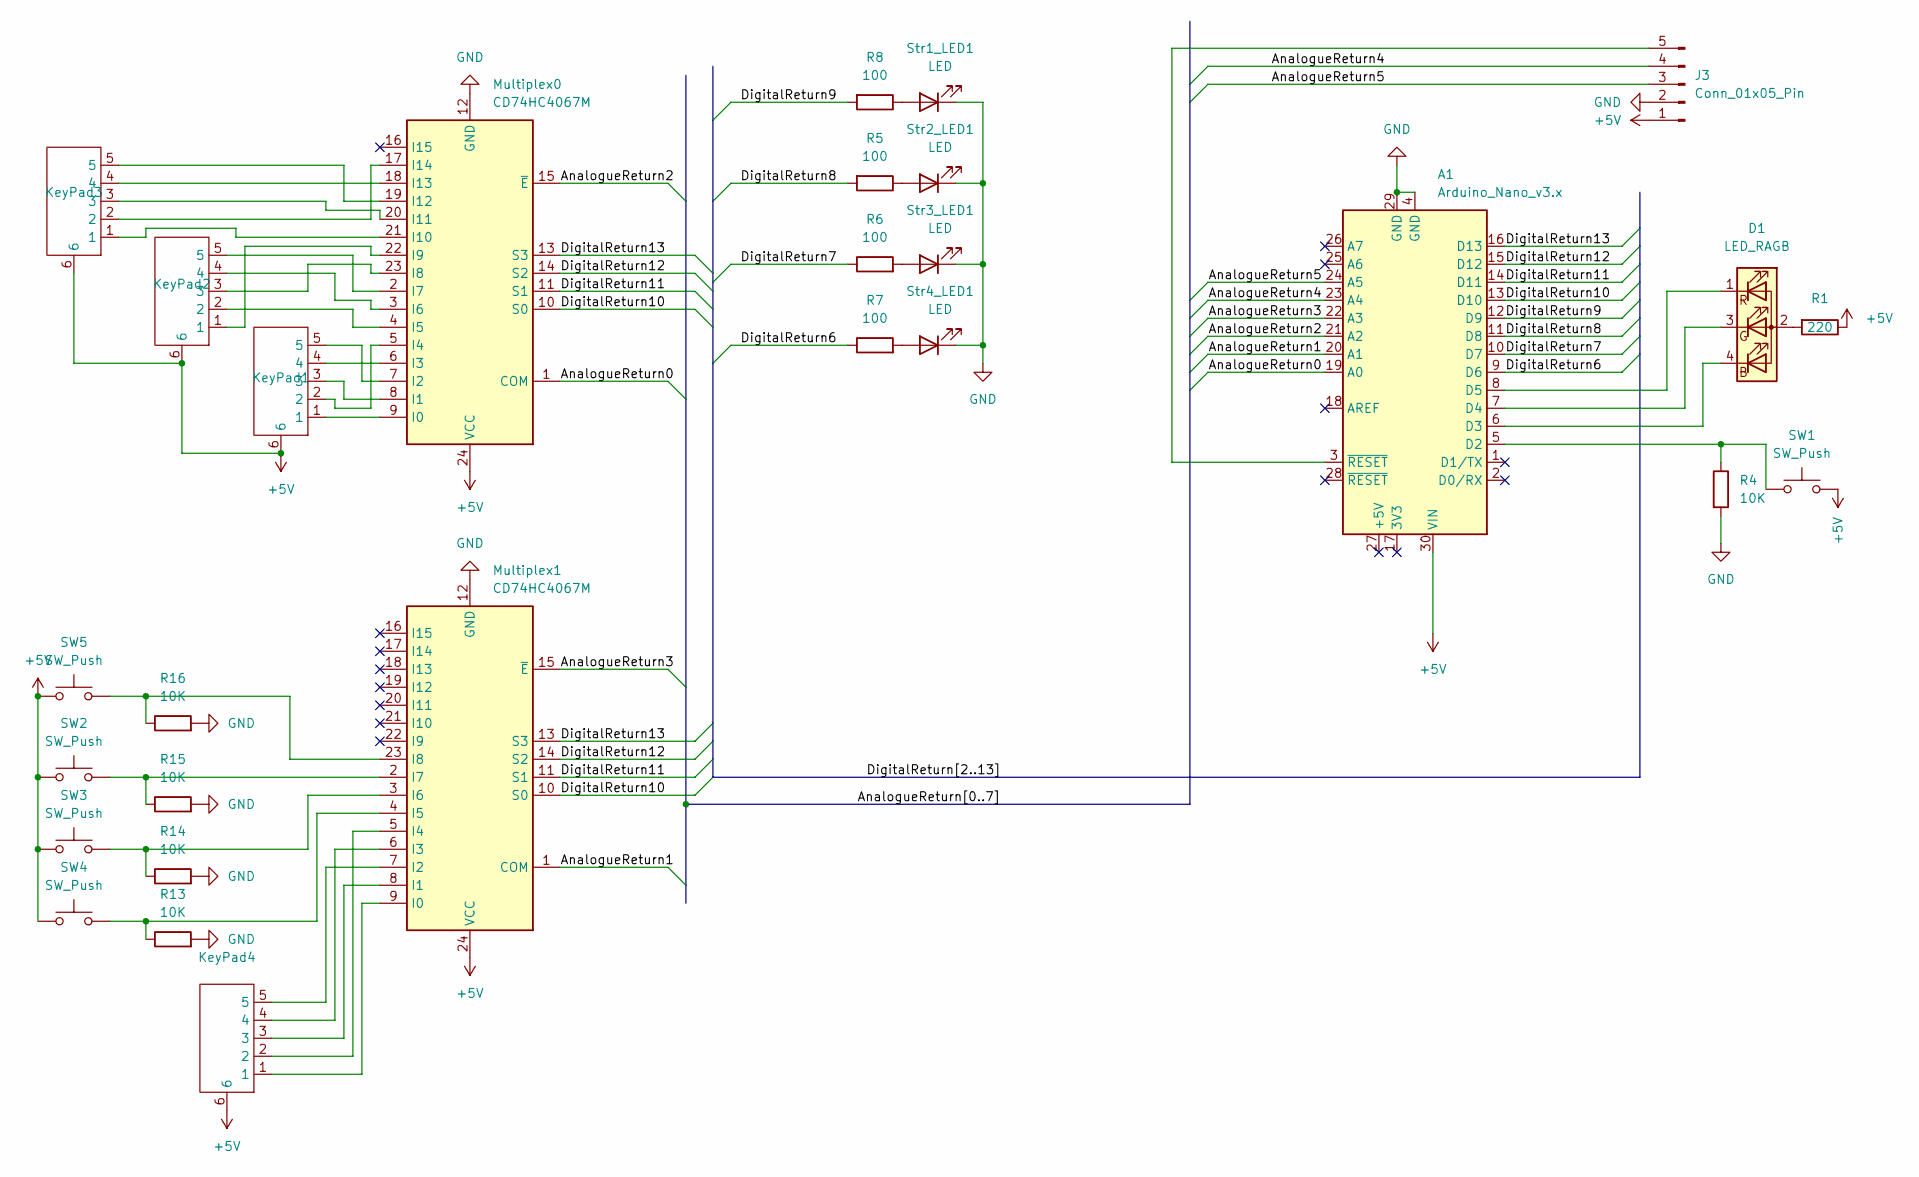
[picture p18: schematic Keyboard_Module.kicad_sch]

Parts:
A1: Arduino_Nano_v3.x; Arduino_Nano
D1: LED_RAGB; LED_D5.0mm-4_RGB_Staggered_Pins
J3: Conn_01x05_Pin; JST_XH_B5B-XH-A_1x05_P2.50mm_Vertical
KeyPad1, KeyPad2, KeyPad3, KeyPad4: Connector_PogoPin_6Pin
Multiplex0, Multiplex1: CD74HC4067M; CD74HC4067M Multiplexer Board
R1: 220; R_Axial_DIN0207_L6.3mm_D2.5mm_P7.62mm_Horizontal
R4, R13, R14, R15, R16: 10K; R_Axial_DIN0207_L6.3mm_D2.5mm_P7.62mm_Horizontal
R5, R6, R7, R8: 100; R_Axial_DIN0207_L6.3mm_D2.5mm_P7.62mm_Horizontal
SW1, SW2, SW3, SW4, SW5: SW_Push; SW_PUSH_6mm_H13mm
Str1_LED1, Str2_LED1, Str3_LED1, Str4_LED1: LED; LED_D5.0mm

Connections:
+5V: A1.30 (VIN), J3.1, KeyPad1.6, KeyPad2.6, KeyPad3.6, KeyPad4.6, Multiplex0.24 (VCC), Multiplex1.24 (VCC), R1.1, SW1.2, SW2.1, SW3.1, SW4.1, SW5.1
/AnalogueReturn0: A1.19 (A0), Multiplex0.1 (COM)
/AnalogueReturn1: A1.20 (A1), Multiplex1.1 (COM)
/AnalogueReturn2: A1.21 (A2), Multiplex0.15 (~E)
/AnalogueReturn3: A1.22 (A3), Multiplex1.15 (~E)
/AnalogueReturn4: A1.23 (A4), J3.4
/AnalogueReturn5: A1.24 (A5), J3.3
/DigitalReturn6: A1.9 (D6), R7.1
/DigitalReturn7: A1.10 (D7), R6.1
/DigitalReturn8: A1.11 (D8), R5.2
/DigitalReturn9: A1.12 (D9), R8.2
/DigitalReturn10: A1.13 (D10), Multiplex0.10 (S0), Multiplex1.10 (S0)
/DigitalReturn11: A1.14 (D11), Multiplex0.11 (S1), Multiplex1.11 (S1)
/DigitalReturn12: A1.15 (D12), Multiplex0.14 (S2), Multiplex1.14 (S2)
/DigitalReturn13: A1.16 (D13), Multiplex0.13 (S3), Multiplex1.13 (S3)
GND: A1.4 (GND), A1.29 (GND), J3.2, Multiplex0.12 (GND), Multiplex1.12 (GND), R4.2, R13.2, R14.2, R15.2, R16.2, Str1_LED1.1 (K), Str2_LED1.1 (K), Str3_LED1.1 (K), Str4_LED1.1 (K)
unnamed: A1.5 (D2), R4.1, SW1.1
unnamed: A1.6 (D3), D1.4 (BK)
unnamed: A1.7 (D4), D1.3 (GK)
unnamed: A1.8 (D5), D1.1 (RK)
unnamed: D1.2 (A), R1.2
unnamed: A1.3 (~RESET), J3.5
unnamed: KeyPad1.1, Multiplex0.9 (I0)
unnamed: KeyPad1.3, Multiplex0.8 (I1)
unnamed: KeyPad1.5, Multiplex0.7 (I2)
unnamed: KeyPad1.4, Multiplex0.6 (I3)
unnamed: KeyPad1.2, Multiplex0.5 (I4)
unnamed: KeyPad2.2, Multiplex0.4 (I5)
unnamed: KeyPad2.4, Multiplex0.3 (I6)
unnamed: KeyPad2.5, Multiplex0.2 (I7)
unnamed: KeyPad2.3, Multiplex0.23 (I8)
unnamed: KeyPad2.1, Multiplex0.22 (I9)
unnamed: KeyPad3.1, Multiplex0.21 (I10)
unnamed: KeyPad3.3, Multiplex0.20 (I11)
unnamed: KeyPad3.5, Multiplex0.19 (I12)
unnamed: KeyPad3.4, Multiplex0.18 (I13)
unnamed: KeyPad3.2, Multiplex0.17 (I14)
unnamed: KeyPad4.1, Multiplex1.9 (I0)
unnamed: KeyPad4.3, Multiplex1.8 (I1)
unnamed: KeyPad4.5, Multiplex1.7 (I2)
unnamed: KeyPad4.4, Multiplex1.6 (I3)
unnamed: KeyPad4.2, Multiplex1.5 (I4)
unnamed: Multiplex1.4 (I5), R13.1, SW4.2
unnamed: Multiplex1.3 (I6), R14.1, SW3.2
unnamed: Multiplex1.2 (I7), R15.1, SW2.2
unnamed: Multiplex1.23 (I8), R16.1, SW5.2
unnamed: R8.1, Str1_LED1.2 (A)
unnamed: R5.1, Str2_LED1.2 (A)
unnamed: R6.2, Str3_LED1.2 (A)
unnamed: R7.2, Str4_LED1.2 (A)

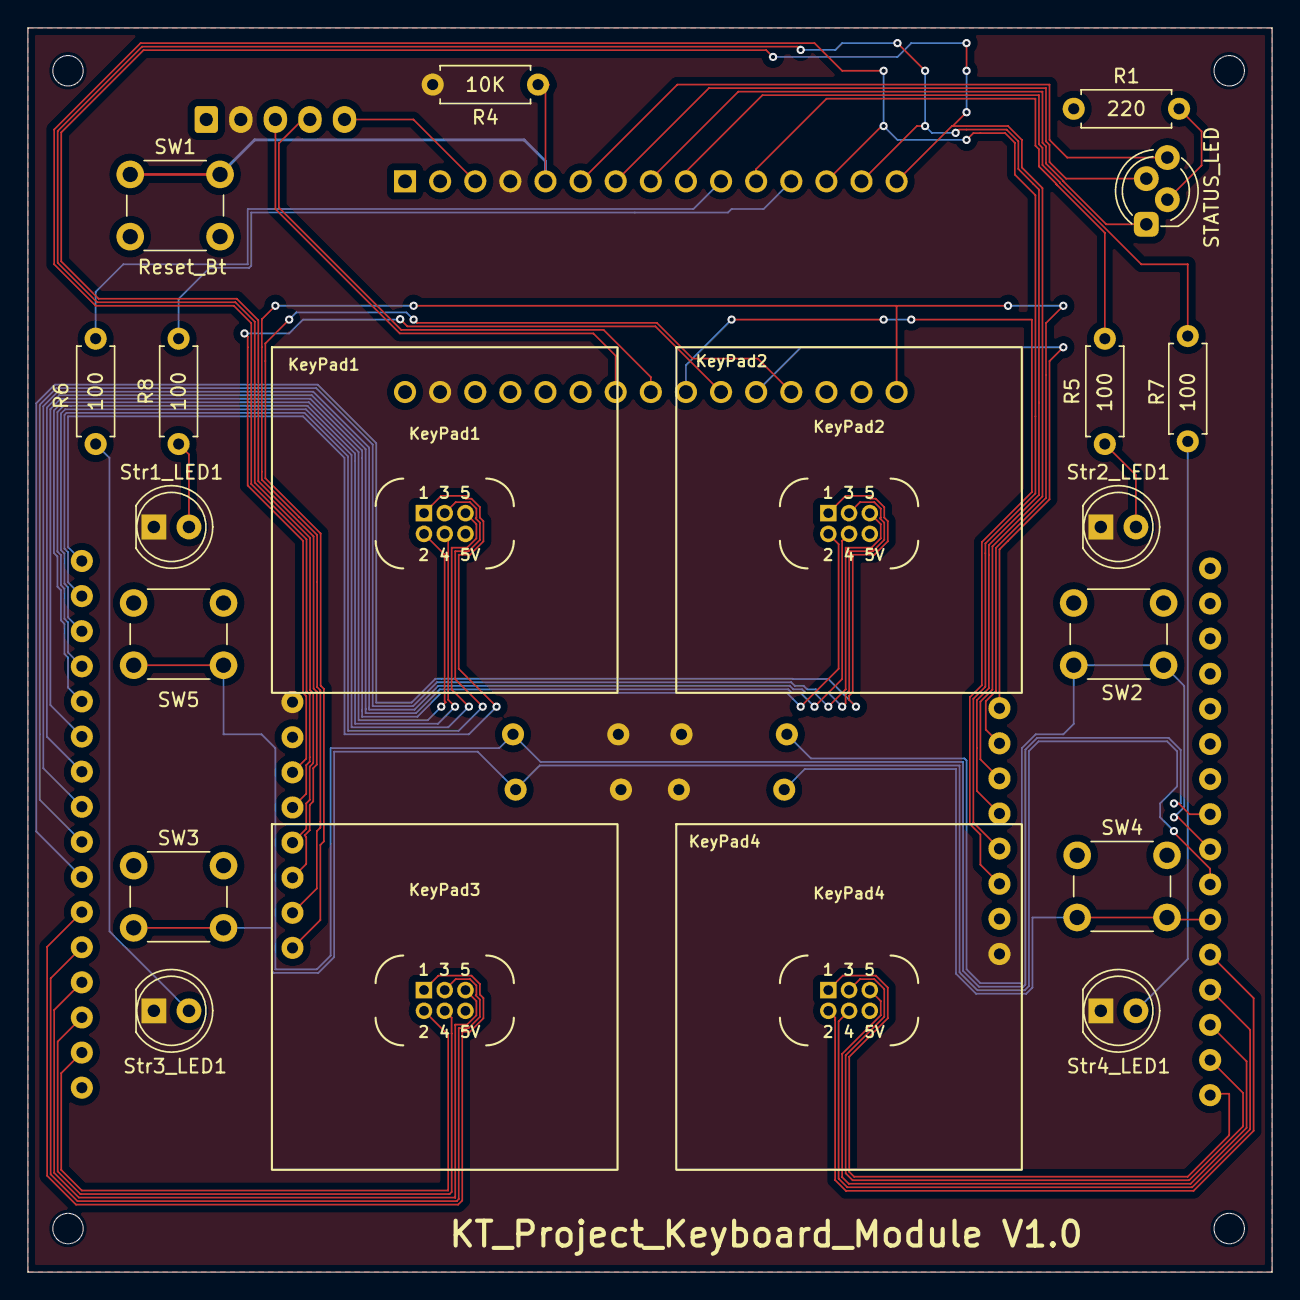
[picture p19: board Keyboard_Module.kicad_pcb from above]

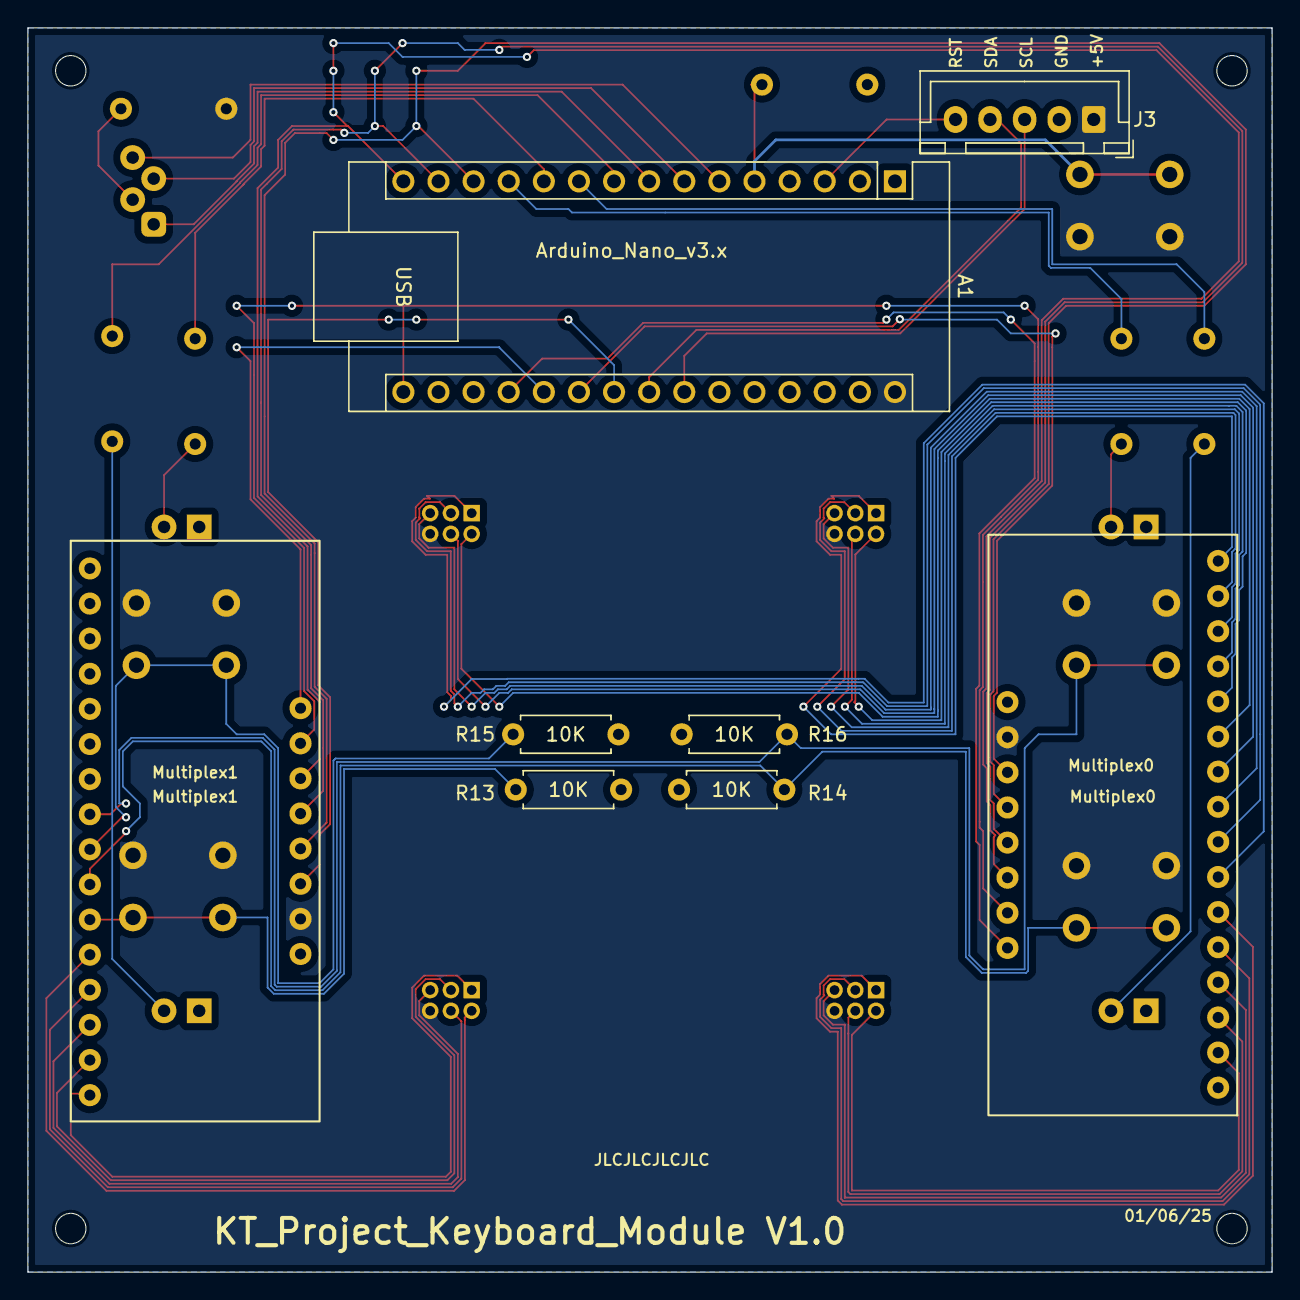
[picture p20: board Keyboard_Module.kicad_pcb from below]

Board: 2 copper layers, 90.0 x 90.0 mm, 28 parts (8 on the bottom side), 50 nets.
