zesamoht/Keep-Talking-Project/kicad/Countdown_Module/Countdown_Module.kicad_pcb

## KiCad design kicad/Countdown_Module/Countdown_Module.kicad_pcb (2026-04-25)

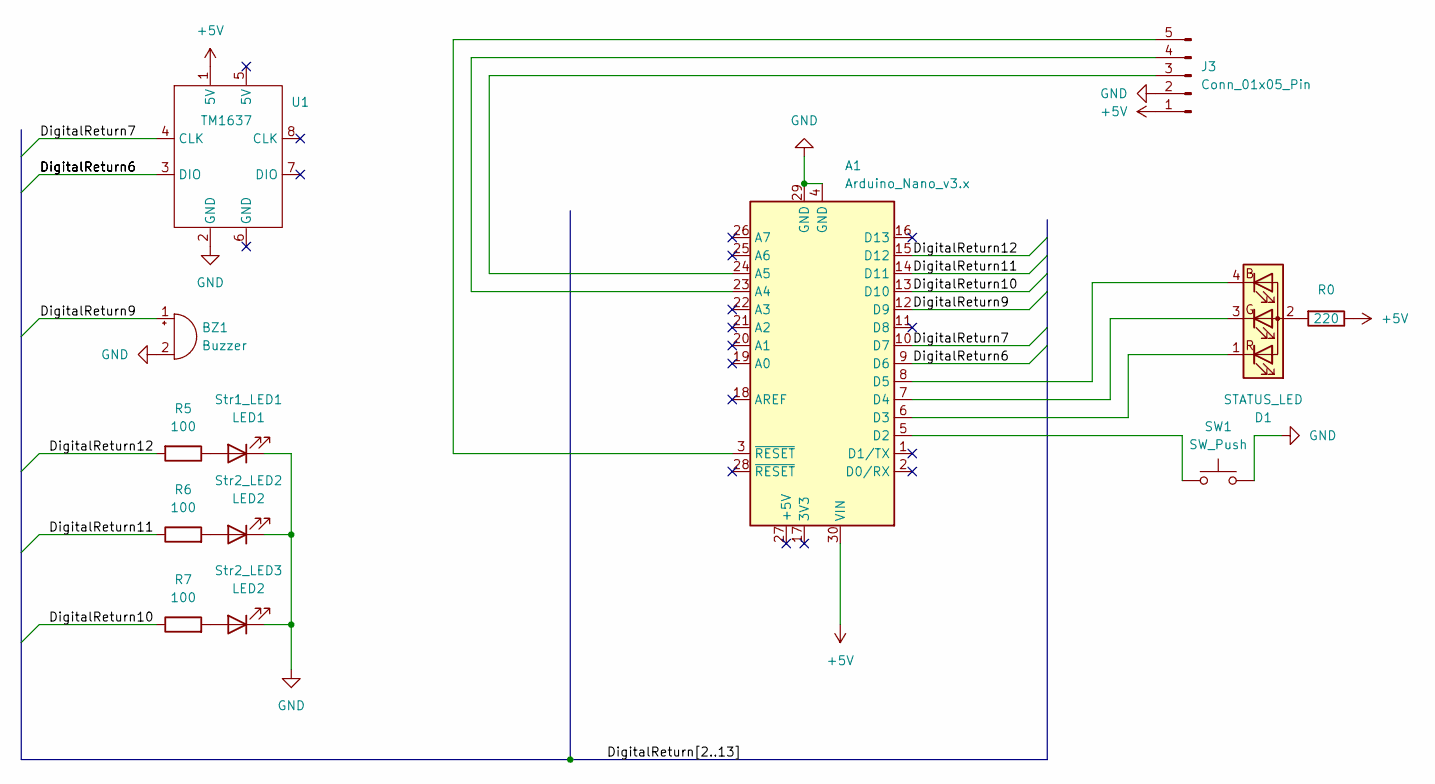
[picture p21: schematic Countdown_Module.kicad_sch]

Parts:
A1: Arduino_Nano_v3.x; Arduino_Nano
BZ1: Buzzer; Speaker_CUI_CMR-1206S-67
D1: STATUS_LED; LED_D5.0mm-4_RGB_Staggered_Pins
J3: Conn_01x05_Pin; JST_XH_B5B-XH-A_1x05_P2.50mm_Vertical
R0: 220; R_Axial_DIN0207_L6.3mm_D2.5mm_P7.62mm_Horizontal
R5, R6, R7: 100; R_Axial_DIN0207_L6.3mm_D2.5mm_P7.62mm_Horizontal
SW1: SW_Push; SW_PUSH_6mm_H13mm
Str1_LED1: LED1; LED_D5.0mm
Str2_LED2, Str2_LED3: LED2; LED_D5.0mm
U1: TM1637; TM1637_4Digits_7Segment_Display

Connections:
+5V: A1.30 (VIN), J3.1, R0.1, U1.1 (5V)
/DigitalReturn6: A1.9 (D6), U1.3 (DIO)
/DigitalReturn7: A1.10 (D7), U1.4 (CLK)
/DigitalReturn9: A1.12 (D9), BZ1.1 (+)
/DigitalReturn10: A1.13 (D10), R7.1
/DigitalReturn11: A1.14 (D11), R6.1
/DigitalReturn12: A1.15 (D12), R5.2
GND: A1.4 (GND), A1.29 (GND), BZ1.2 (-), J3.2, SW1.2, Str1_LED1.1 (K), Str2_LED2.1 (K), Str2_LED3.1 (K), U1.2 (GND)
unnamed: A1.23 (A4), J3.4
unnamed: A1.24 (A5), J3.3
unnamed: A1.5 (D2), SW1.1
unnamed: A1.6 (D3), D1.1 (RK)
unnamed: A1.7 (D4), D1.3 (GK)
unnamed: A1.8 (D5), D1.4 (BK)
unnamed: D1.2 (A), R0.2
unnamed: A1.3 (~RESET), J3.5
unnamed: R5.1, Str1_LED1.2 (A)
unnamed: R6.2, Str2_LED2.2 (A)
unnamed: R7.2, Str2_LED3.2 (A)

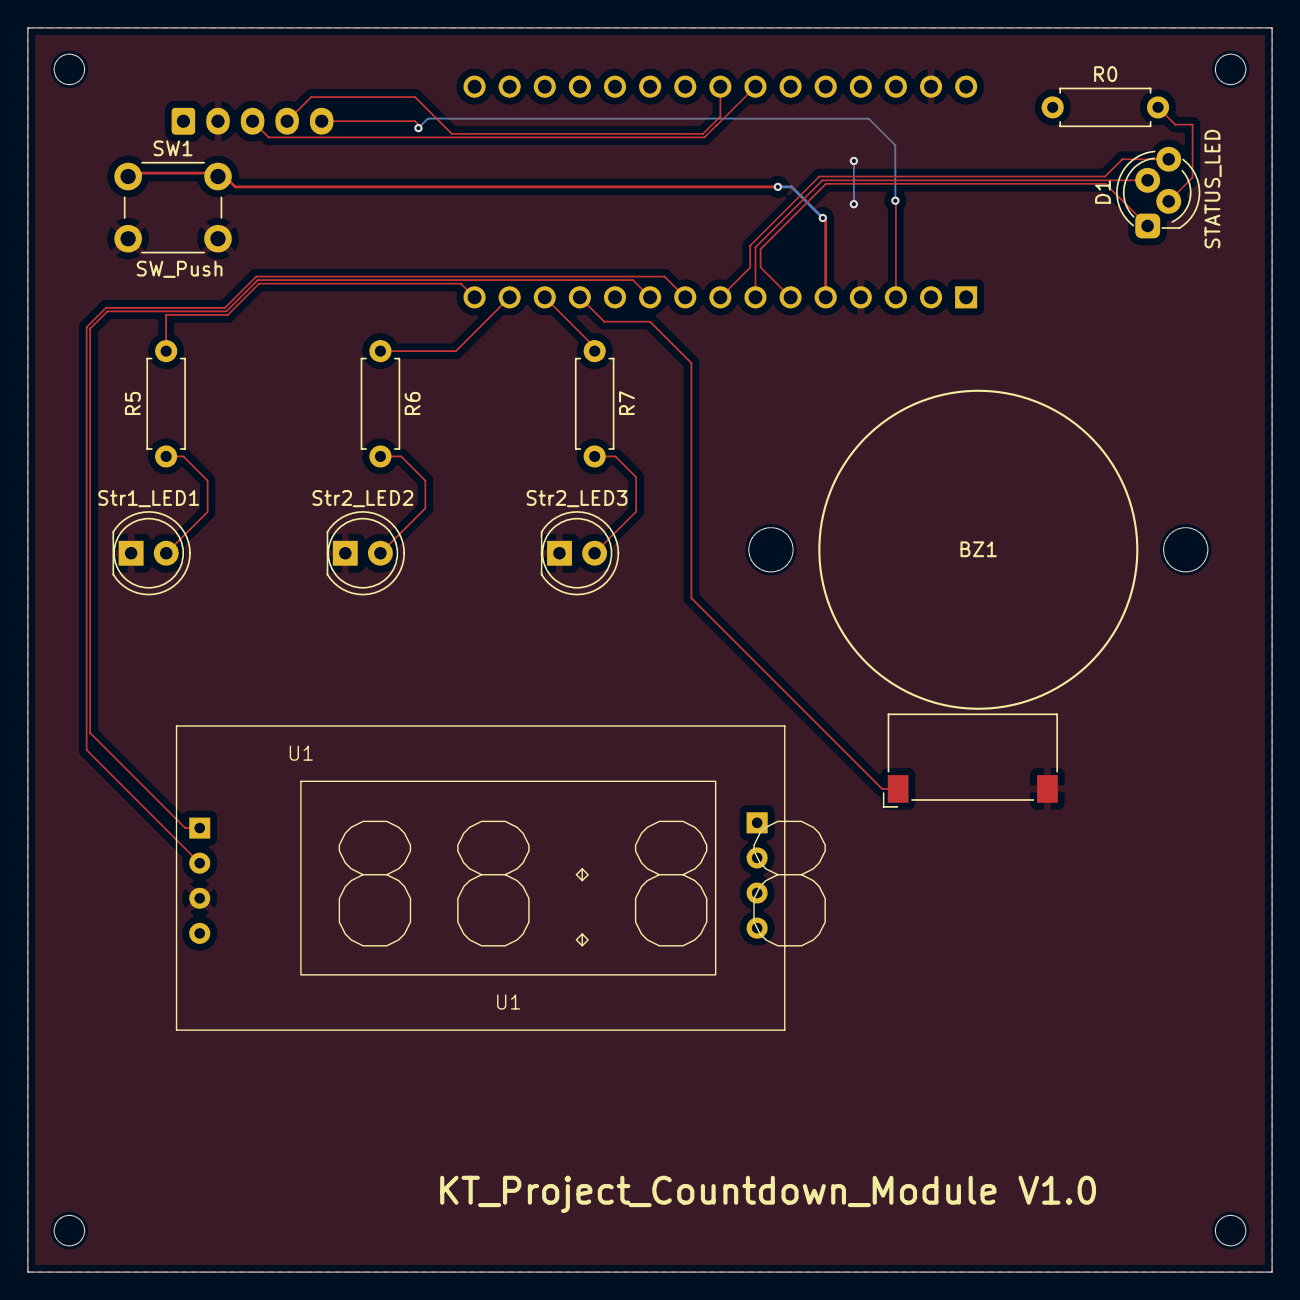
[picture p22: board Countdown_Module.kicad_pcb from above]

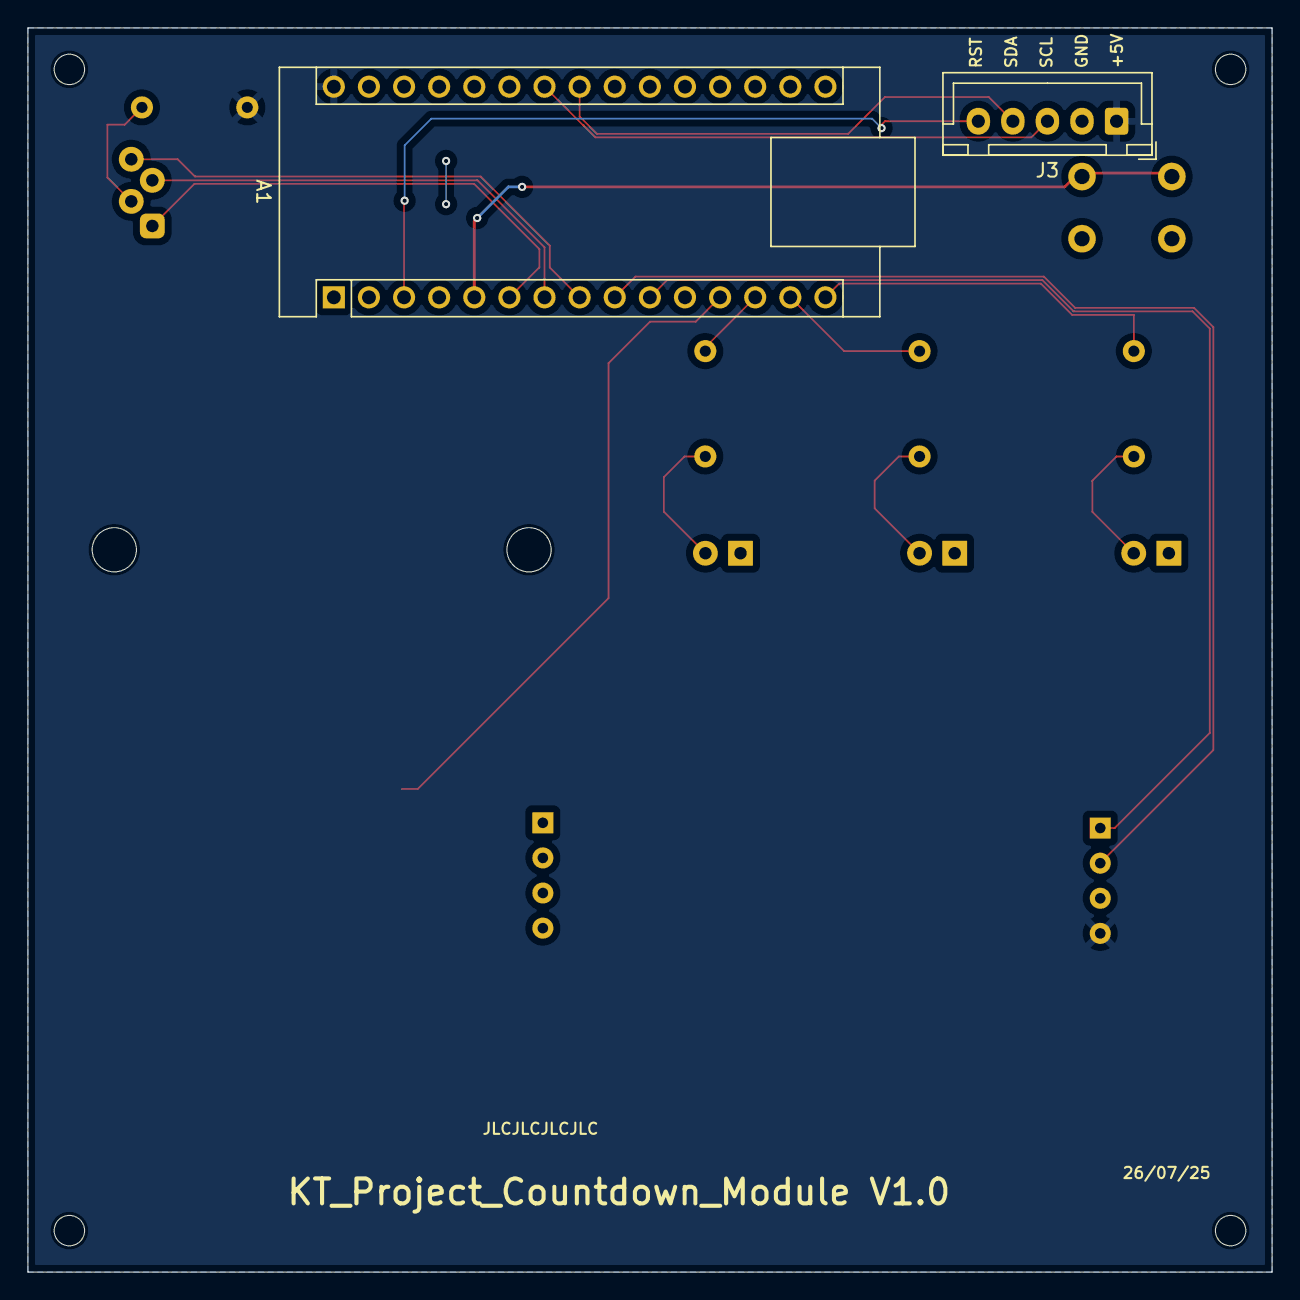
[picture p23: board Countdown_Module.kicad_pcb from below]

Board: 2 copper layers, 90.0 x 90.0 mm, 13 parts (2 on the bottom side), 19 nets.
