zesamoht/Keep-Talking-Project/kicad/Wire_Module/Wire_Module.kicad_pcb

## KiCad design kicad/Wire_Module/Wire_Module.kicad_pcb (2026-04-25)

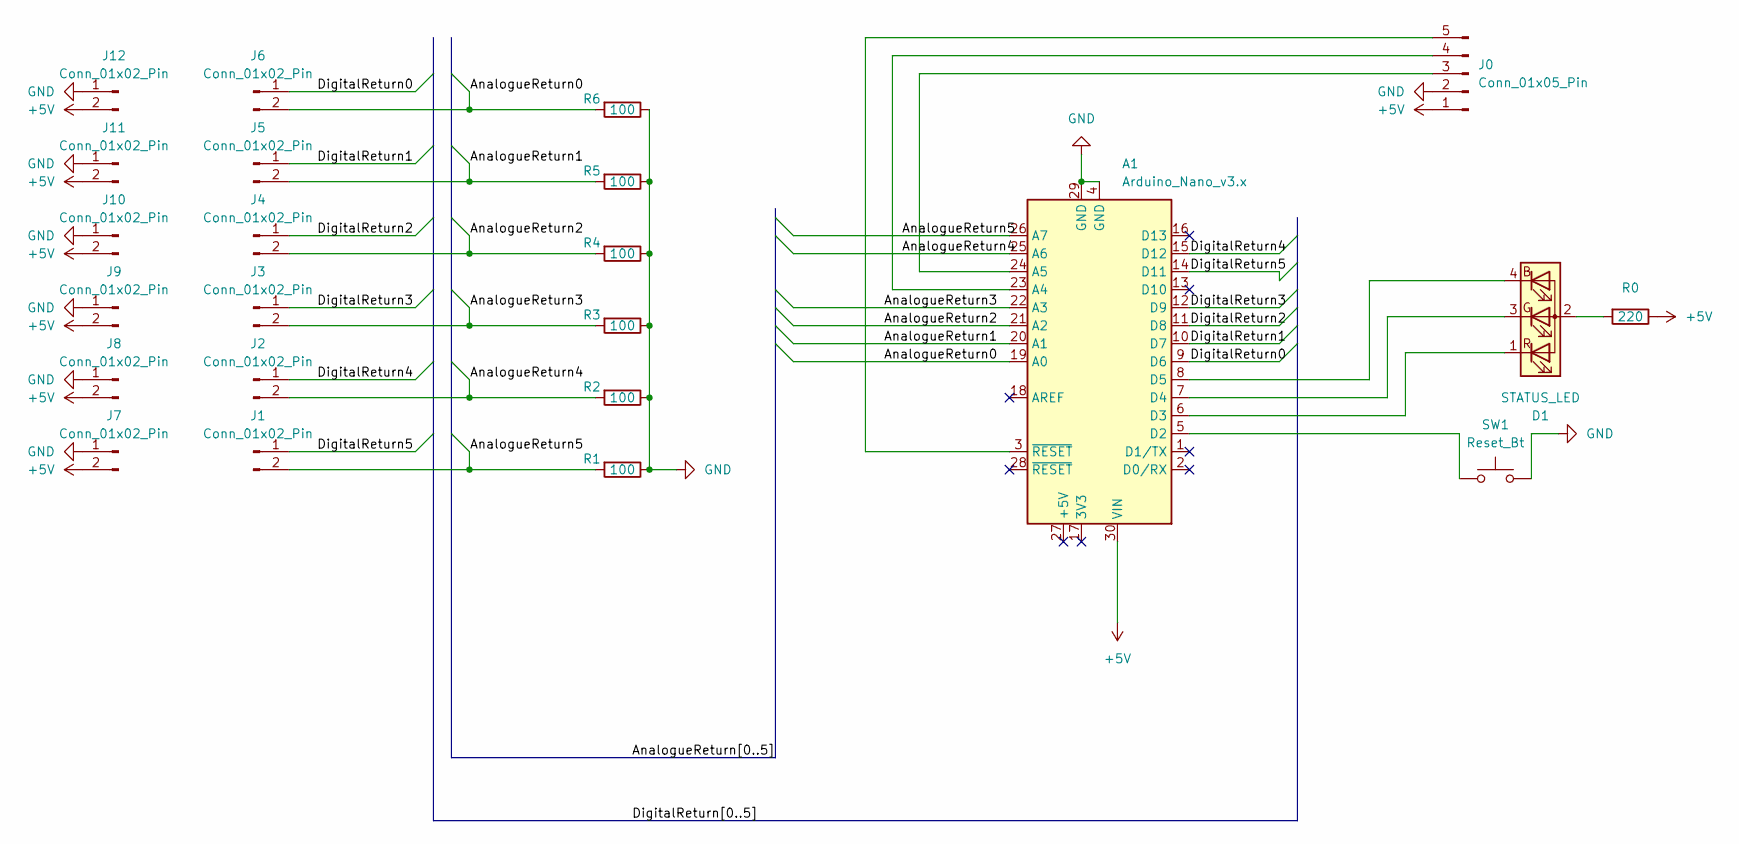
[picture p24: schematic Wire_Module.kicad_sch]

Parts:
A1: Arduino_Nano_v3.x; Arduino_Nano
D1: STATUS_LED; LED_D5.0mm-4_RGB_Staggered_Pins
J0: Conn_01x05_Pin; JST_XH_B5B-XH-A_1x05_P2.50mm_Vertical
J1, J2, J3, J4, J5, J6, J7, J8, J9, J10, J11, J12: Conn_01x02_Pin; JST_XH_B2B-XH-A_1x02_P2.50mm_Vertical
R0: 220; R_Axial_DIN0207_L6.3mm_D2.5mm_P7.62mm_Horizontal
R1, R2, R3, R4, R5, R6: 100; R_Axial_DIN0207_L6.3mm_D2.5mm_P7.62mm_Horizontal
SW1: Reset_Bt; SW_PUSH_6mm_H13mm

Connections:
+5V: A1.30 (VIN), J0.1, J7.2, J8.2, J9.2, J10.2, J11.2, J12.2, R0.1
/AnalogueReturn0: A1.19 (A0), J6.2, R6.2
/AnalogueReturn1: A1.20 (A1), J5.2, R5.2
/AnalogueReturn2: A1.21 (A2), J4.2, R4.2
/AnalogueReturn3: A1.22 (A3), J3.2, R3.2
/AnalogueReturn4: A1.25 (A6), J2.2, R2.2
/AnalogueReturn5: A1.26 (A7), J1.2, R1.2
/DigitalReturn0: A1.9 (D6), J6.1
/DigitalReturn1: A1.10 (D7), J5.1
/DigitalReturn2: A1.11 (D8), J4.1
/DigitalReturn3: A1.12 (D9), J3.1
/DigitalReturn4: A1.15 (D12), J2.1
/DigitalReturn5: A1.14 (D11), J1.1
GND: A1.4 (GND), A1.29 (GND), J0.2, J7.1, J8.1, J9.1, J10.1, J11.1, J12.1, R1.1, R2.1, R3.1, R4.1, R5.1, R6.1, SW1.2
unnamed: A1.23 (A4), J0.4
unnamed: A1.24 (A5), J0.3
unnamed: A1.5 (D2), SW1.1
unnamed: A1.6 (D3), D1.1 (RK)
unnamed: A1.7 (D4), D1.3 (GK)
unnamed: A1.8 (D5), D1.4 (BK)
unnamed: D1.2 (A), R0.2
unnamed: A1.3 (~RESET), J0.5

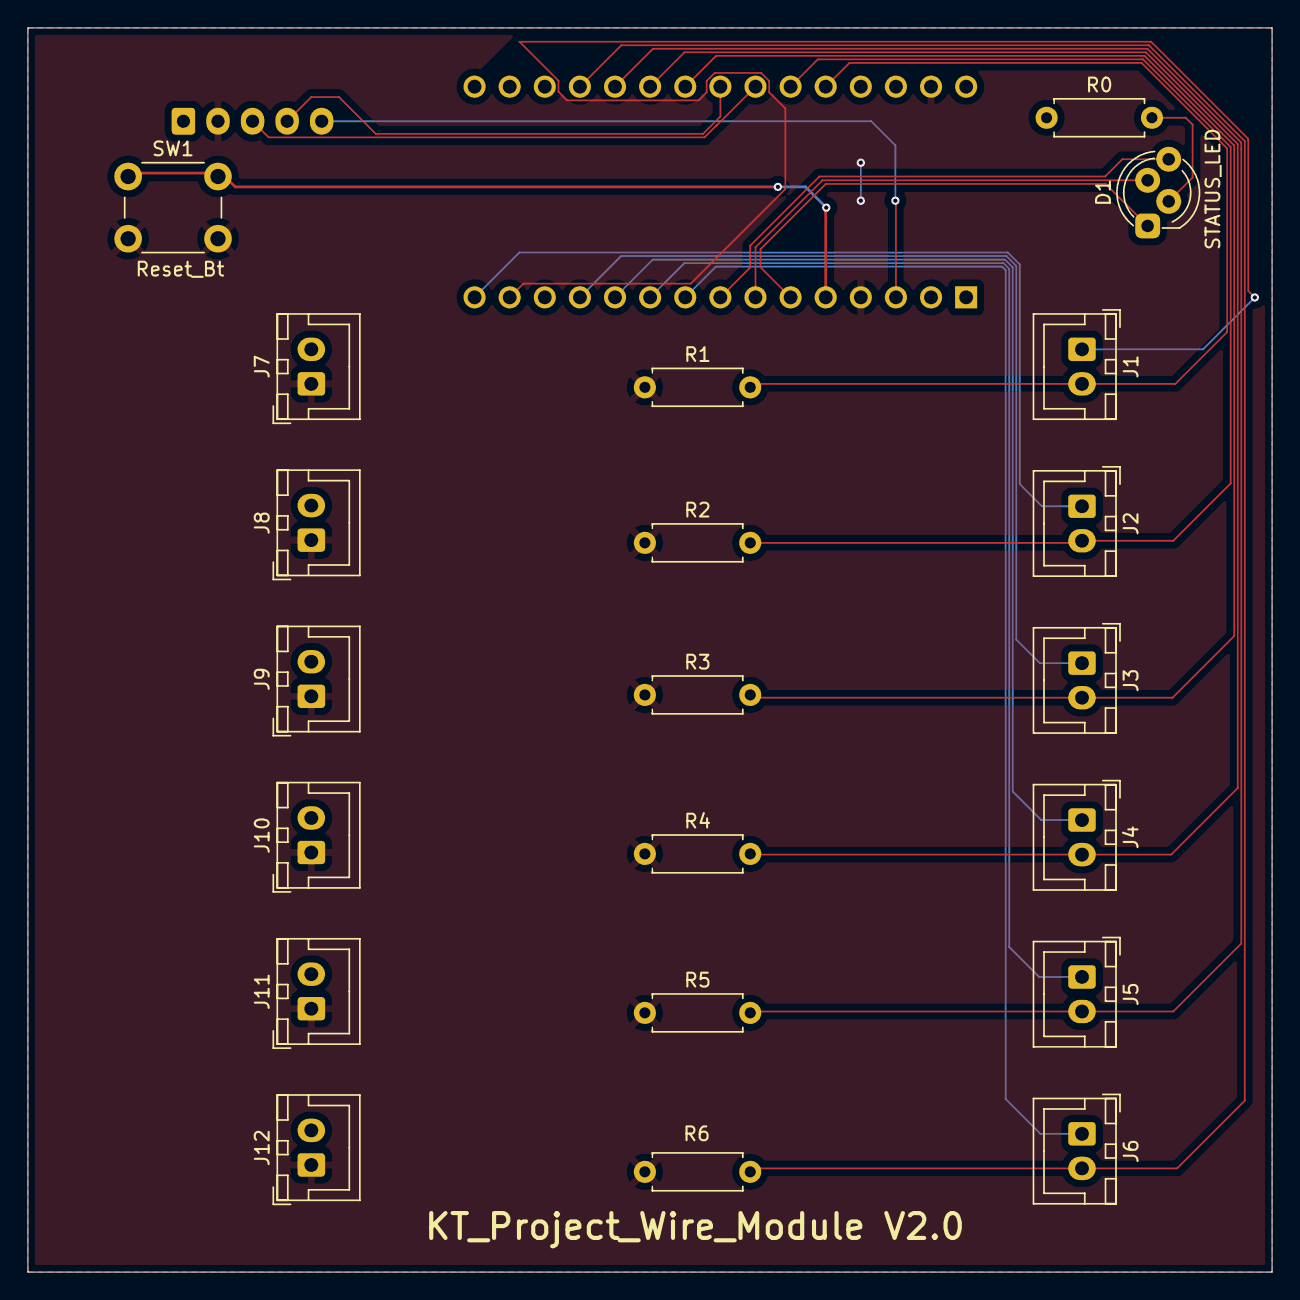
[picture p25: board Wire_Module.kicad_pcb from above]

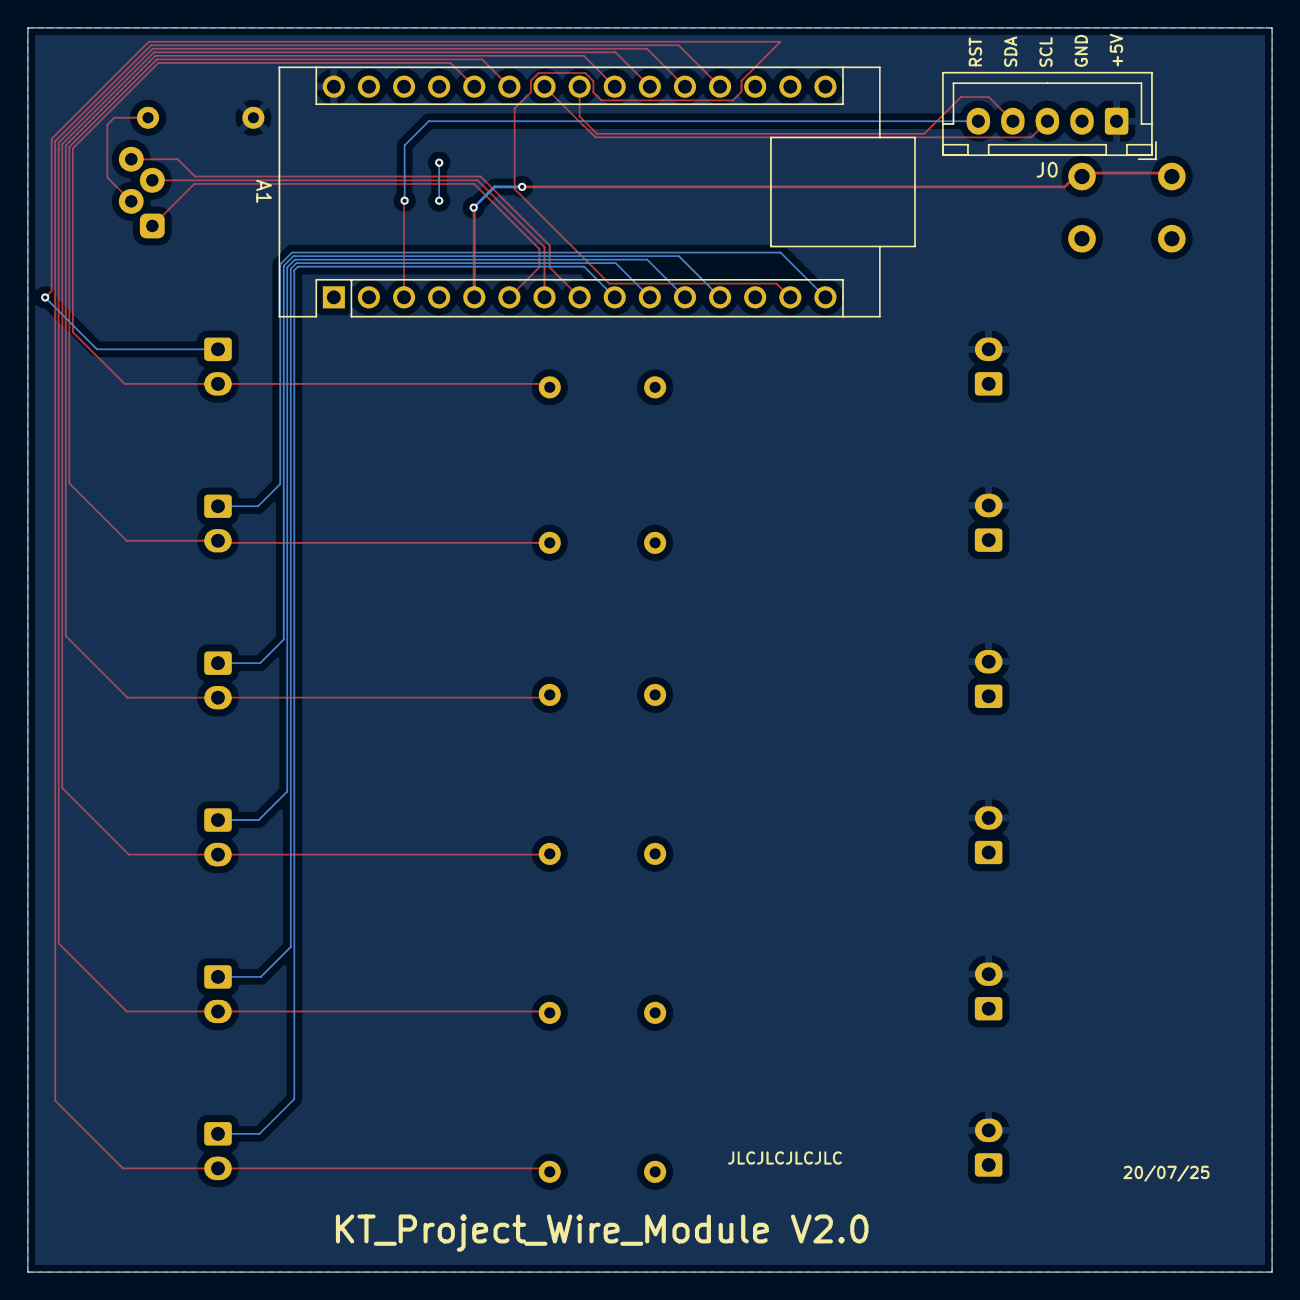
[picture p26: board Wire_Module.kicad_pcb from below]

Board: 2 copper layers, 90.0 x 90.0 mm, 23 parts (2 on the bottom side), 22 nets.
