zesamoht/Keep-Talking-Project/(commit log)

2026-04-25 Create .gitignore for Kicad useless files
2026-04-25 Create README.md
    For all the arduino code module per module
2026-04-25 Kicad for Button Module
    [Button_Module.kicad_pcb, Button_Module.kicad_sch, Button_Module.step]
2026-04-25 Wire module Kickad upload
    [Wire_Module.kicad_pcb, Wire_Module.kicad_sch, Wire_Module.step]
2026-04-25 Countdown module Kickad
    [Countdown_Module.kicad_pcb, Countdown_Module.kicad_sch, Countdown_Module.step]
2026-04-25 Maze_Module Kicad
    [Maze_Module.kicad_pcb, Maze_Module.kicad_sch, Maze_Module.step]
2026-04-25 Upload all Kicad
    [EdgeWork_Module.step, Keypad_PCB.kicad_pcb, Keypad_PCB.kicad_sch, Keypad_PCB.step, Memory_Module.kicad_pcb, Memory_Module.kicad_sch, Password_Module.kicad_pcb, Password_Module.kicad_sch]
2026-04-25 Upload all Arduino code
2026-06-06 refactor hold button logic
2026-06-07 Fix keyboard join state and live button scanning
    [KT_Module_Keyboard.ino]
2026-06-07 Preserve mainline comments in keyboard fix
    [KT_Module_Keyboard.ino]
2026-06-07 Decode keyboard keys using PCB channel order
2026-06-07 Update KT_Module_Keyboard.ino
    Change button array order to match physical pinout
